LearningByMaking/Hardware/AppBoard1.3/partsReference.png

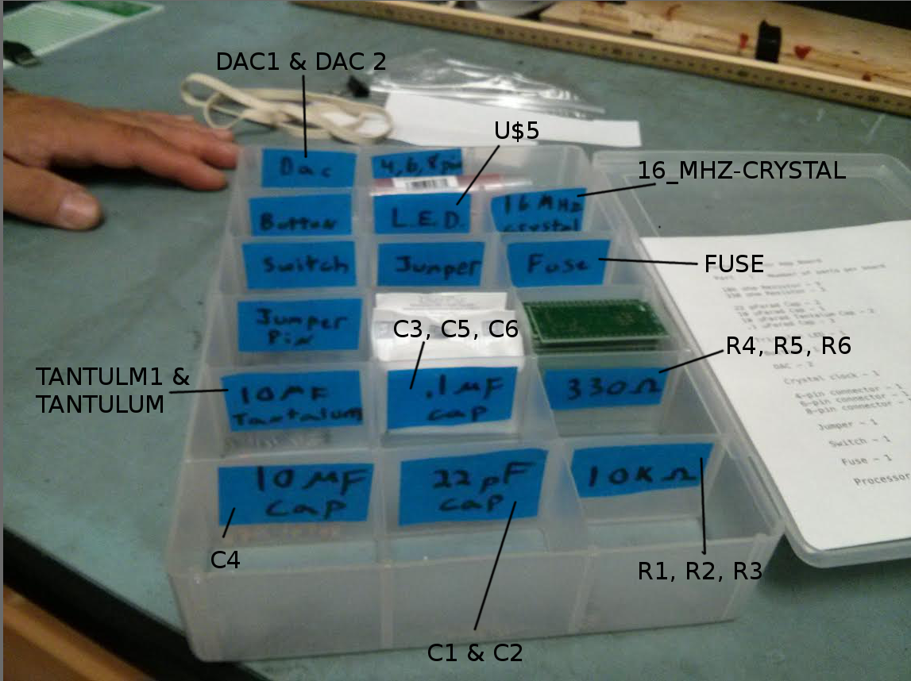
AppBoard1.3/partsReference.png
