LearningByMaking/Hardware/AppBoard1.3/Images/top_blank.jpg

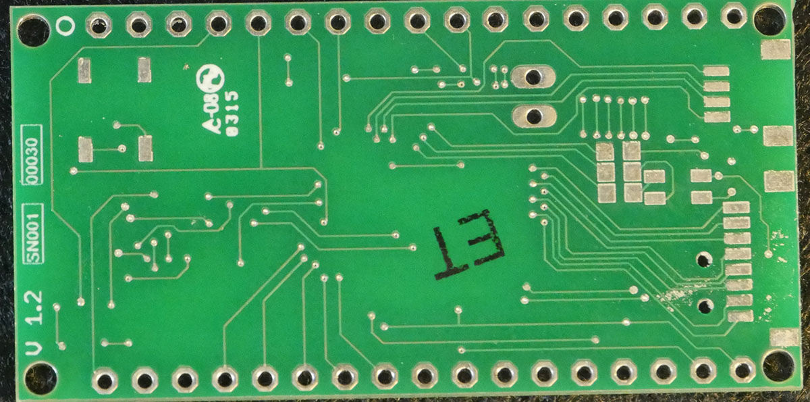
AppBoard1.3/Images/top_blank.jpg
