LearningByMaking/Hardware/README.md

# Hardware
The design files and documentation for the LbyM hardware
