LearningByMaking/Hardware/Protoboard/Docs/OuterHousing/CubeSat_mechanical-20160218-201846.pdf

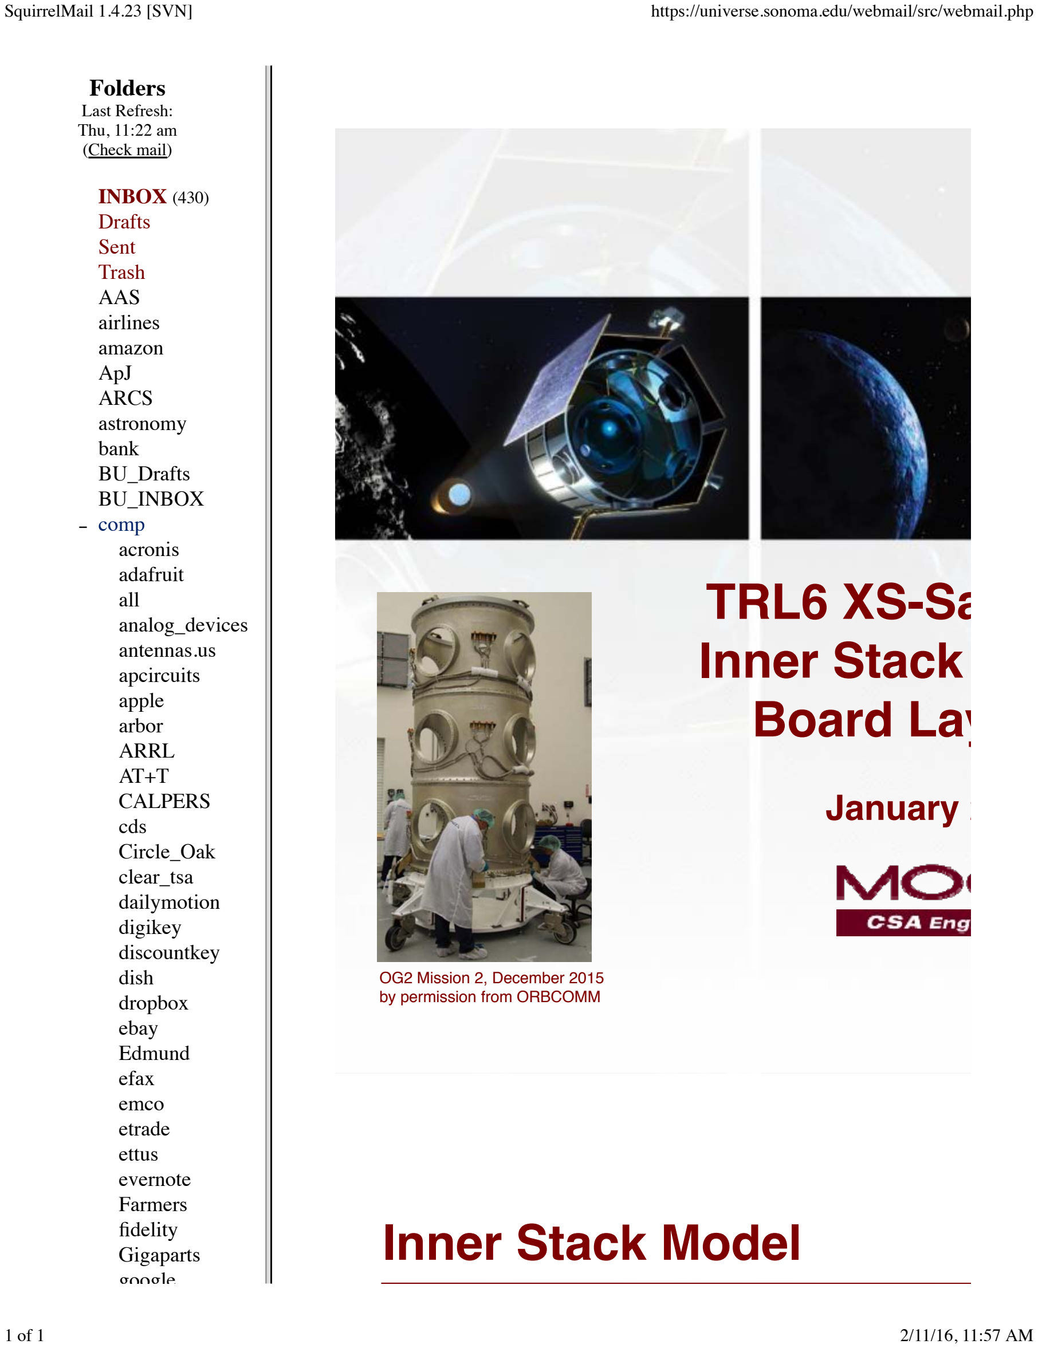
[picture p3: page 1]

Folders
Last Refresh:
Thu, 11:22 am
(Check mail)

INBOX (430)
Drafts
Sent
Trash
AAS
airlines
amazon
ApJ
ARCS
astronomy
bank
BU_Drafts
BU_INBOX
- comp
acronis
adafruit
all
analog_devices
antennas.us
apcircuits
apple
arbor
ARRL
AT+T
CALPERS
cds
Circle_Oak
clear_tsa
dailymotion
digikey
discountkey
dish
dropbox
ebay
Edmund
efax
emco
etrade
ettus
evernote
Farmers
fidelity
Gigaparts
google

# TRL6 XS-Sa Inner Stack Board Lay

## January 2

OG2 Mission 2, December 2015 by permission from ORBCOMM

# Inner Stack Model

SquirrelMail 1.4.23 [SVN] | https://universe.sonoma.edu/webmail/src/webmail.php
1 of 1 | 2/11/16, 11:57 AM
