LearningByMaking/Hardware/Protoboard/Docs/OuterHousing/XS-Sat Board Layout ICD 28Jan2016-20160212-193028.pdf

This technical Data/Drawing/Document contains information that is proprietary to, and is the express property of Moog Inc., or Moog Inc. subsidiaries except as expressly granted by contract or by operation of law and is restricted to use by only Moog employees and other persons authorized in writing by Moog or as expressly granted by contract or by operation of law. No portion of this Data/Drawing/Document shall be reproduced or disclosed or copied or furnished in whole or in part to others or used by others for any purpose whatsoever except as specifically authorized in writing by an authorized signatory of Moog Inc. or Moog Inc. subsidiaries.

# TRL6 XS-Sat CubeSat Inner Stack Model and Board Layout ICD

# January 28, 2016

## OG2 Mission 2, December 2015 by permission from ORBCOMM

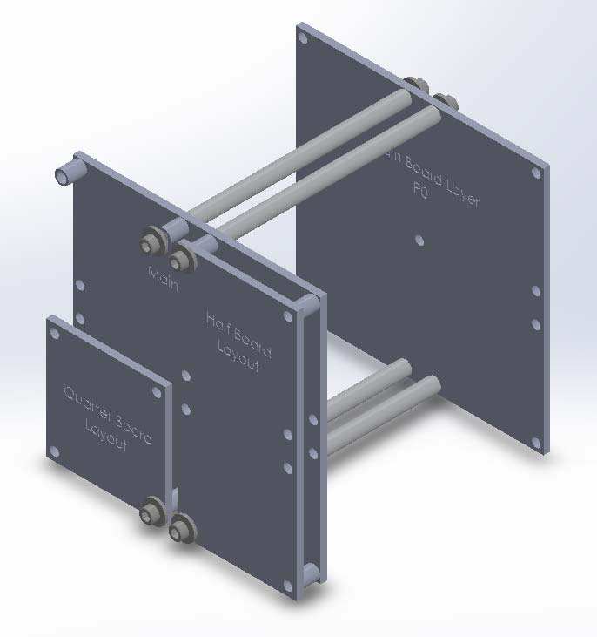
[picture p4: figure]

1 Moog Inc. Proprietary – see first slide for restrictions.

# Inner Stack Model

# Board Layouts and Templates Mechanical ICD

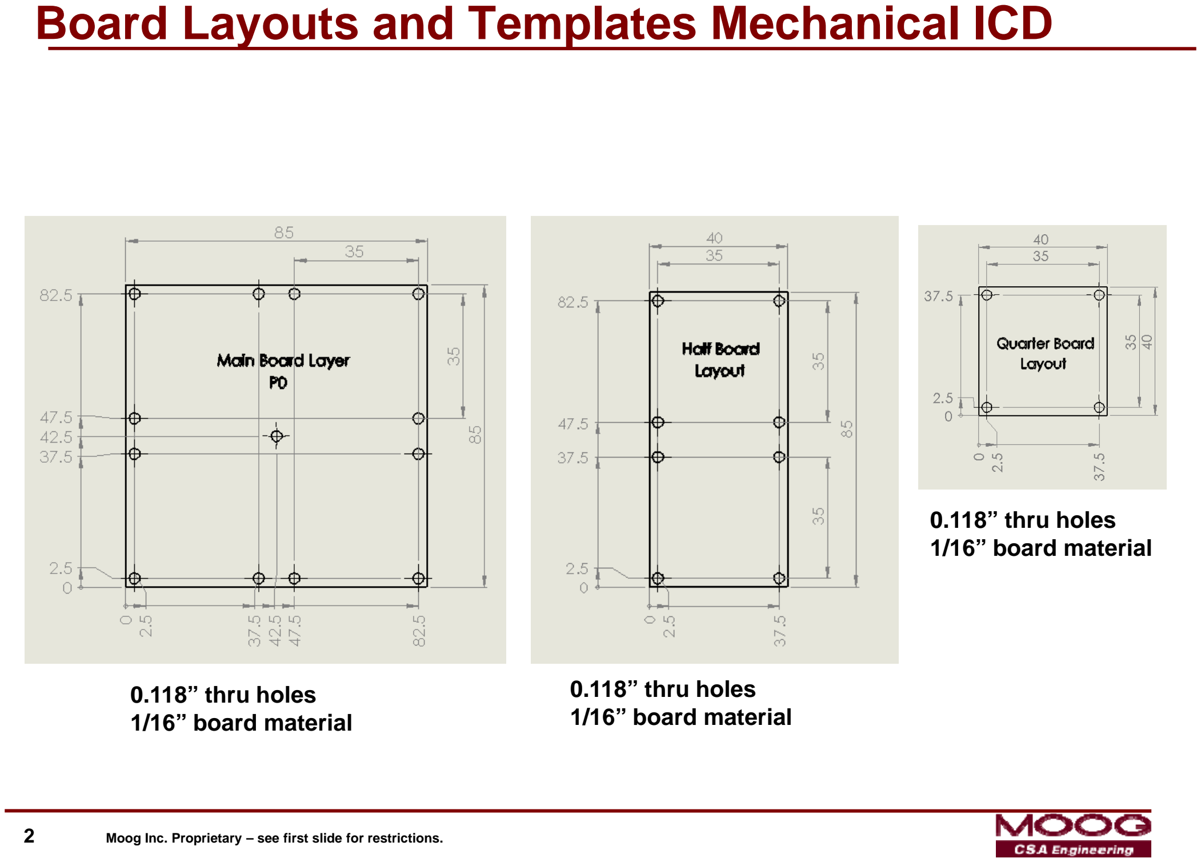
[picture p5: page 3]

2 Moog Inc. Proprietary – see first slide for restrictions.

# 0.118” thru holes 1/16” board material

# 0.118” thru holes 1/16” board material

# 0.118” thru holes 1/16” board material

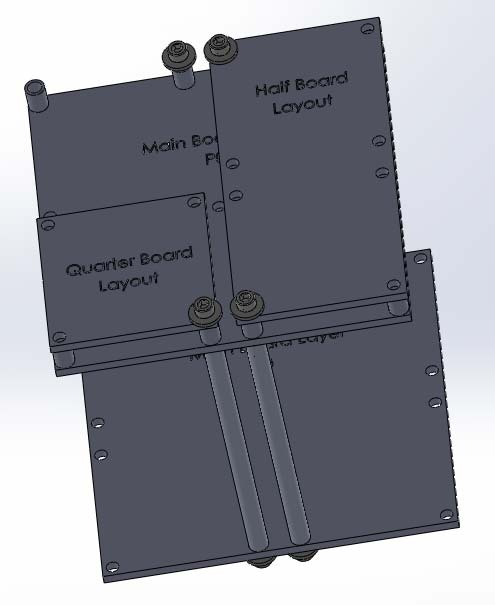
[picture p6: figure]

3 Moog Inc. Proprietary – see first slide for restrictions.

# Electrical ICD

# - Corner holes of Full Board are all ground - Middle holes need to be alternating Signal and Power

# – Layout of signal and power is still TBD
