LearningByMaking/Hardware/AppBoard1.3/Images/bottom.jpg

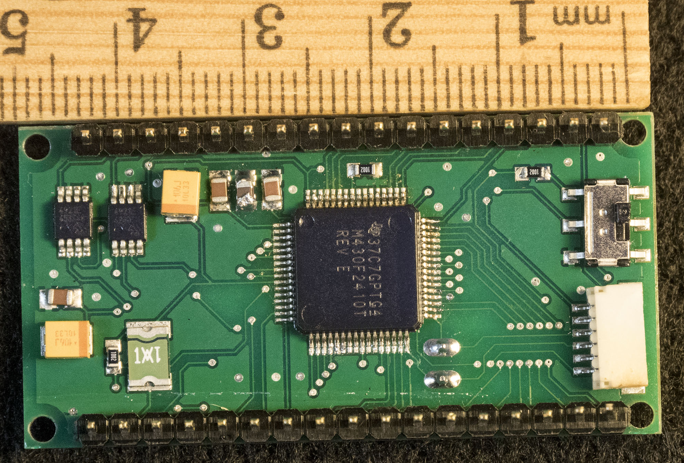
AppBoard1.3/Images/bottom.jpg
