LearningByMaking/Hardware/AppBoard1.3/Images/bottom_blank.jpg

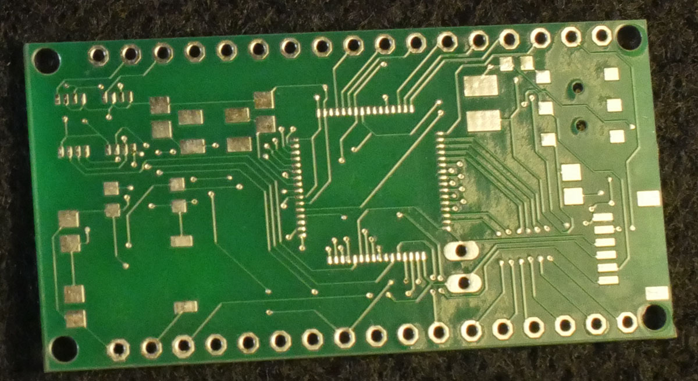
AppBoard1.3/Images/bottom_blank.jpg
