LearningByMaking/Hardware/AppBoard1.3/Images/bottom_with_header_pins.jpg

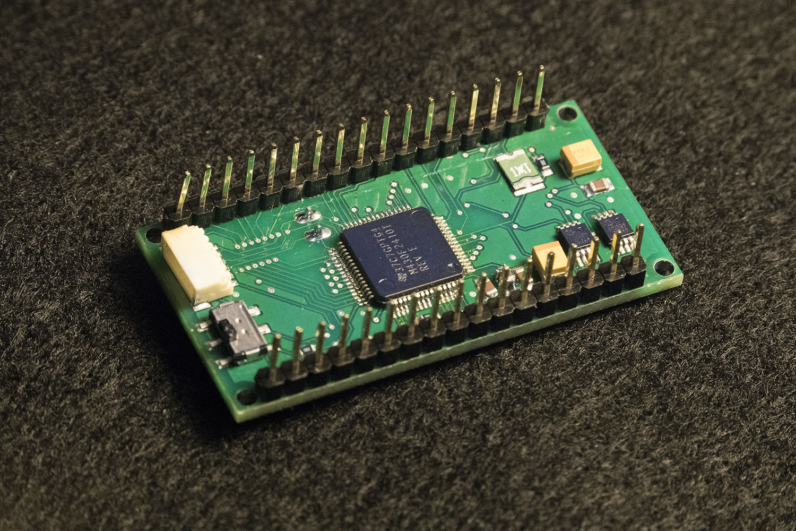
AppBoard1.3/Images/bottom_with_header_pins.jpg
