LearningByMaking/Hardware/AppBoard1.3/Images/top.jpg

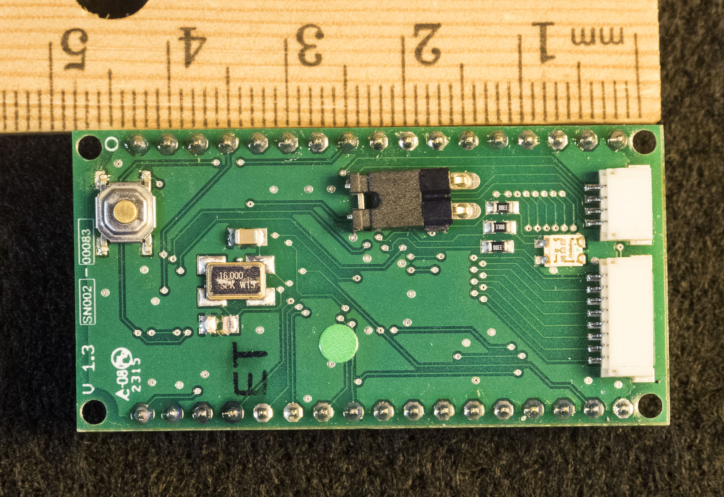
AppBoard1.3/Images/top.jpg
