LearningByMaking/Hardware/Protoboard/prototype-bottom_brd.png

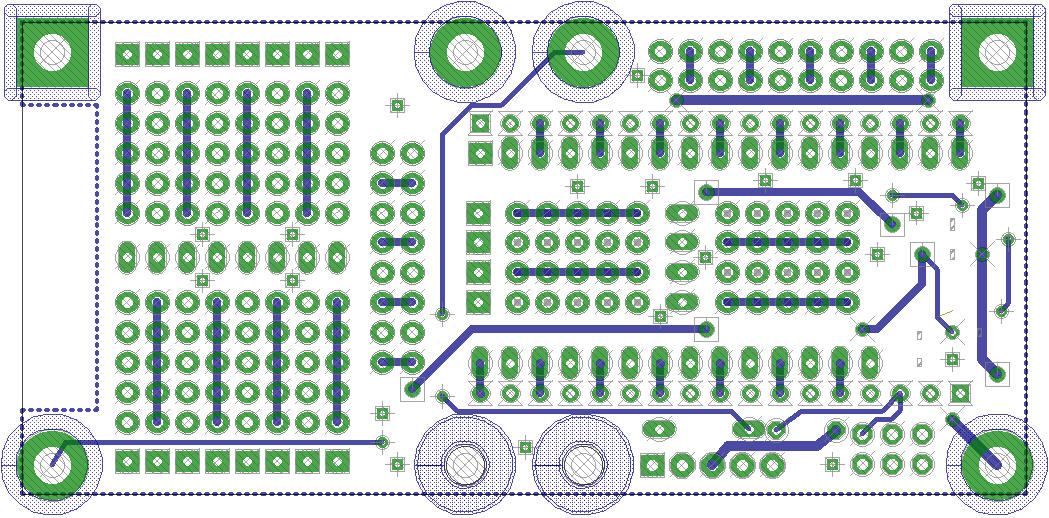
Protoboard/prototype-bottom_brd.png
