LearningByMaking/Hardware/Protoboard/prototype-bottom_w_gnd-plane_brd.png

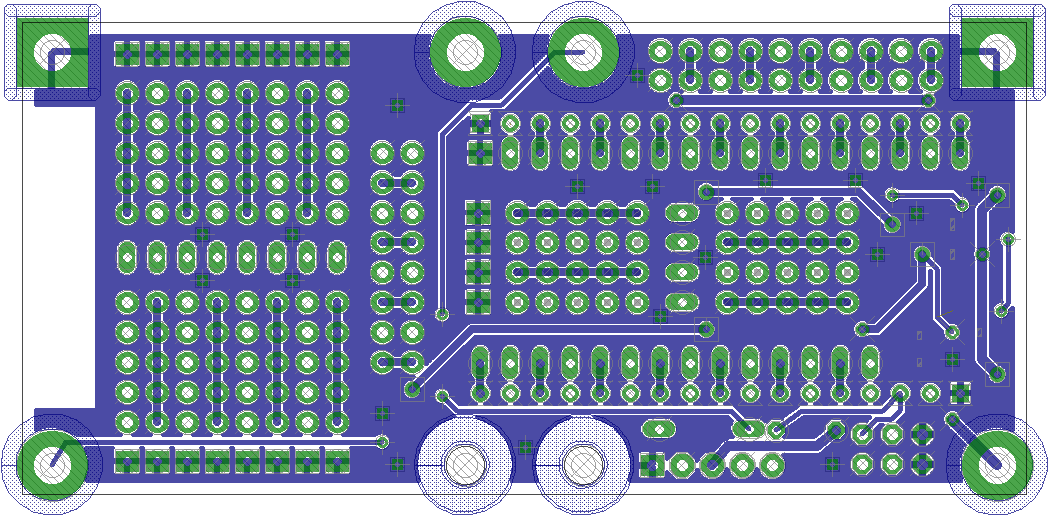
Protoboard/prototype-bottom_w_gnd-plane_brd.png
