LearningByMaking/Hardware/Protoboard/prototype-top-and-bottom_brd.png

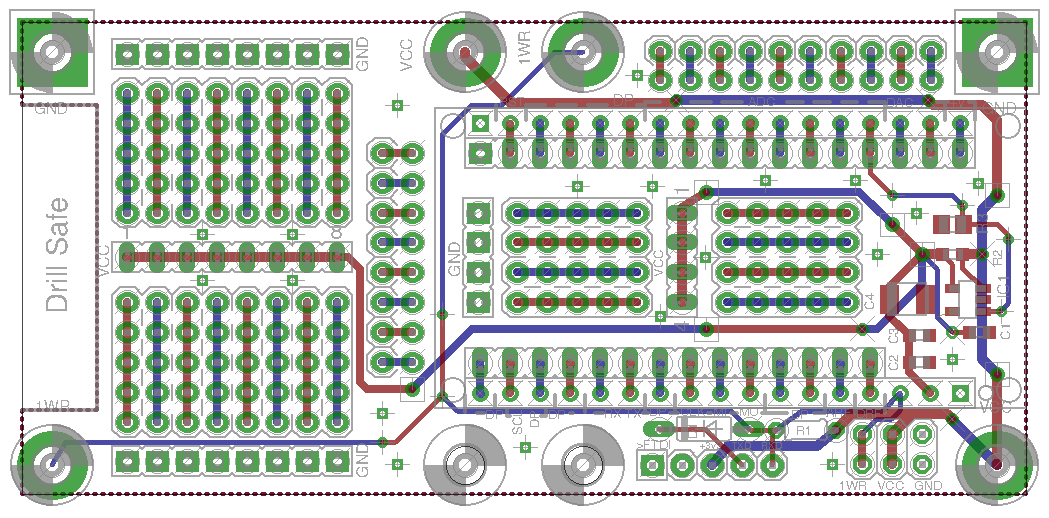
Protoboard/prototype-top-and-bottom_brd.png
