LearningByMaking/Hardware/Protoboard/prototype-top_brd.png

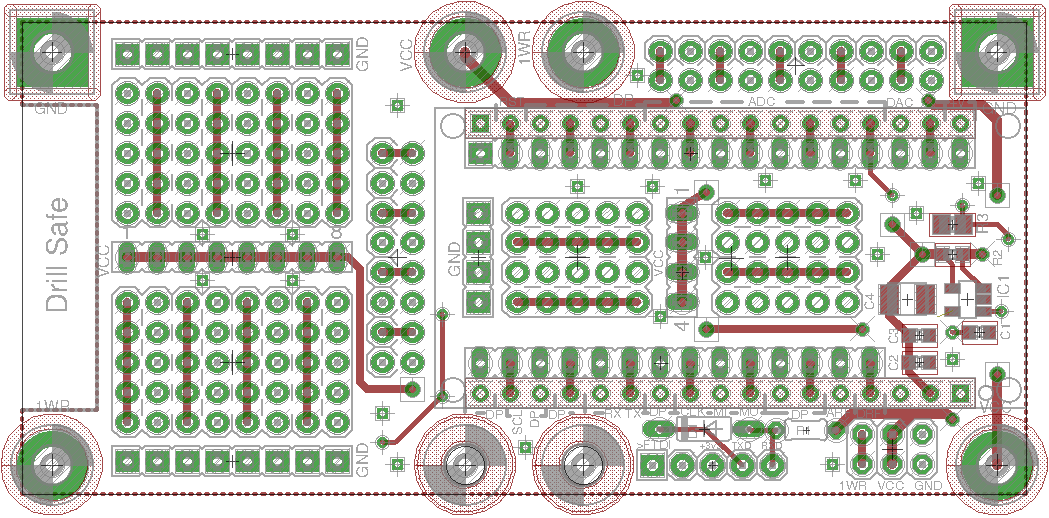
Protoboard/prototype-top_brd.png
