LearningByMaking/Hardware/Protoboard/prototype-top_w_gnd-plane_brd.png

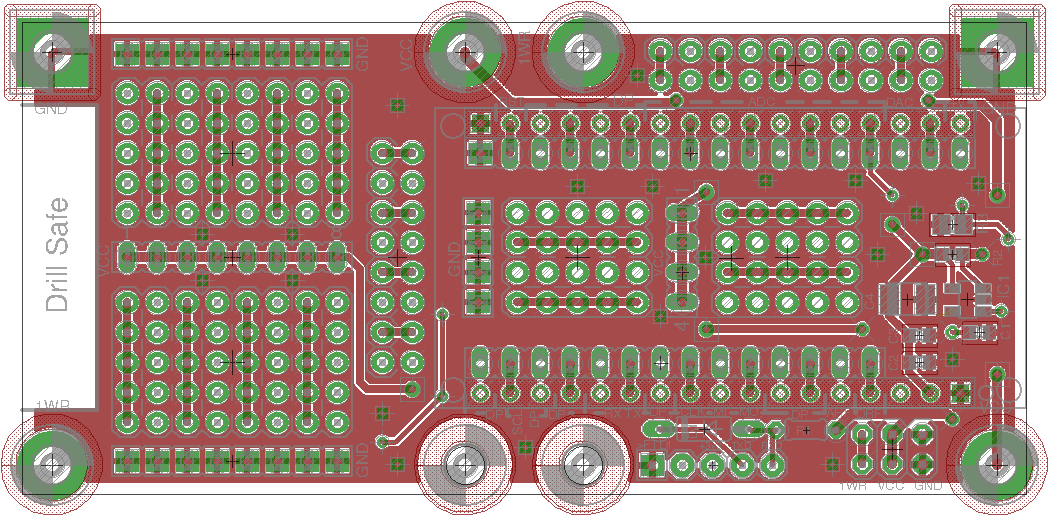
Protoboard/prototype-top_w_gnd-plane_brd.png
