LearningByMaking/Hardware/uStar/Layout.png

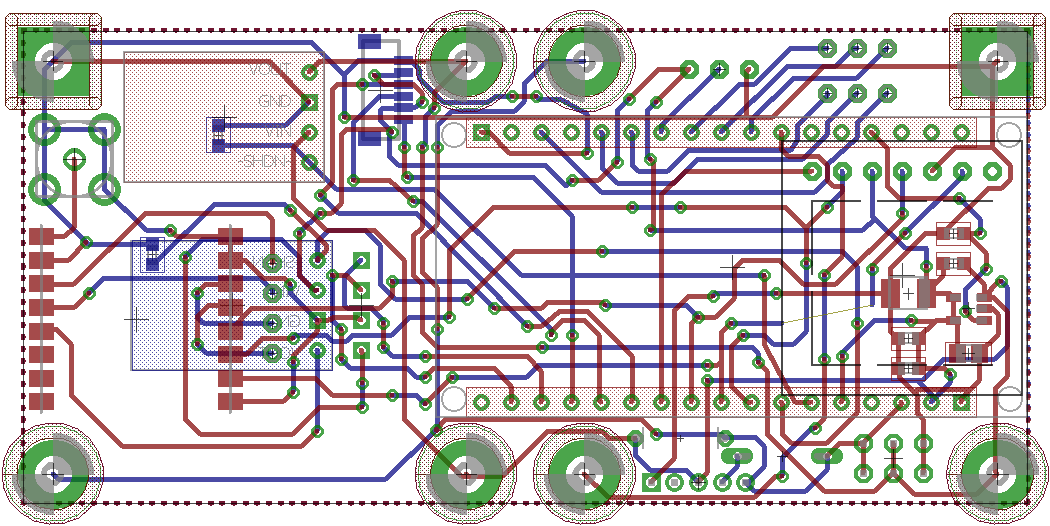
uStar/Layout.png
