LearningByMaking/Hardware/uStar/PlacementGuid.png

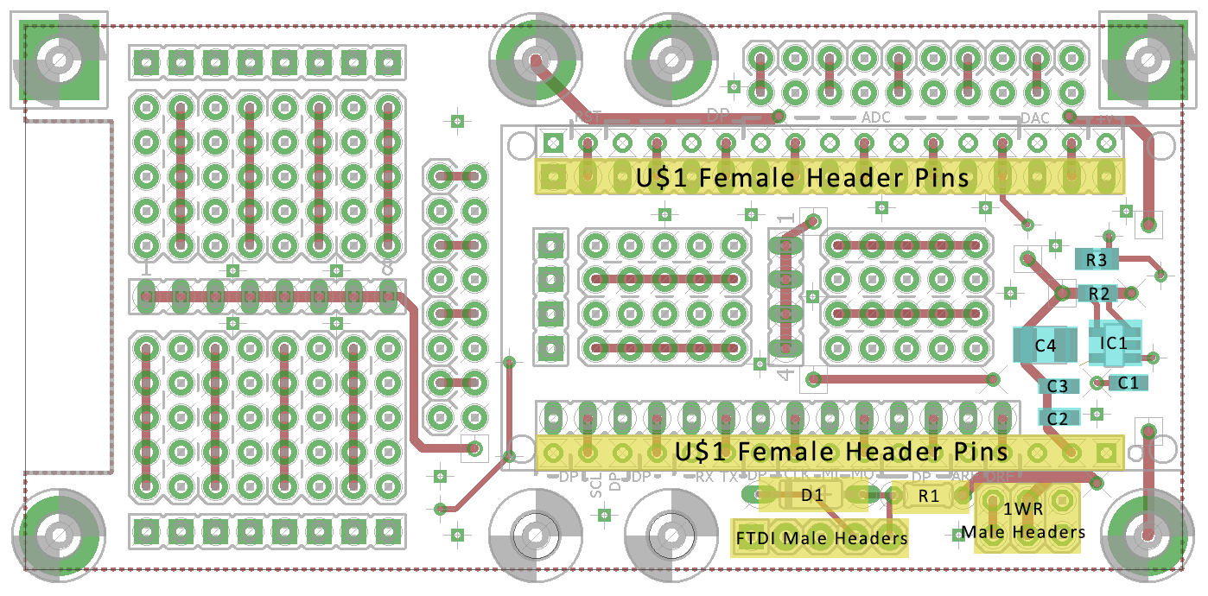
uStar/PlacementGuid.png
