LearningByMaking/Hardware/uStar/Schematic.png

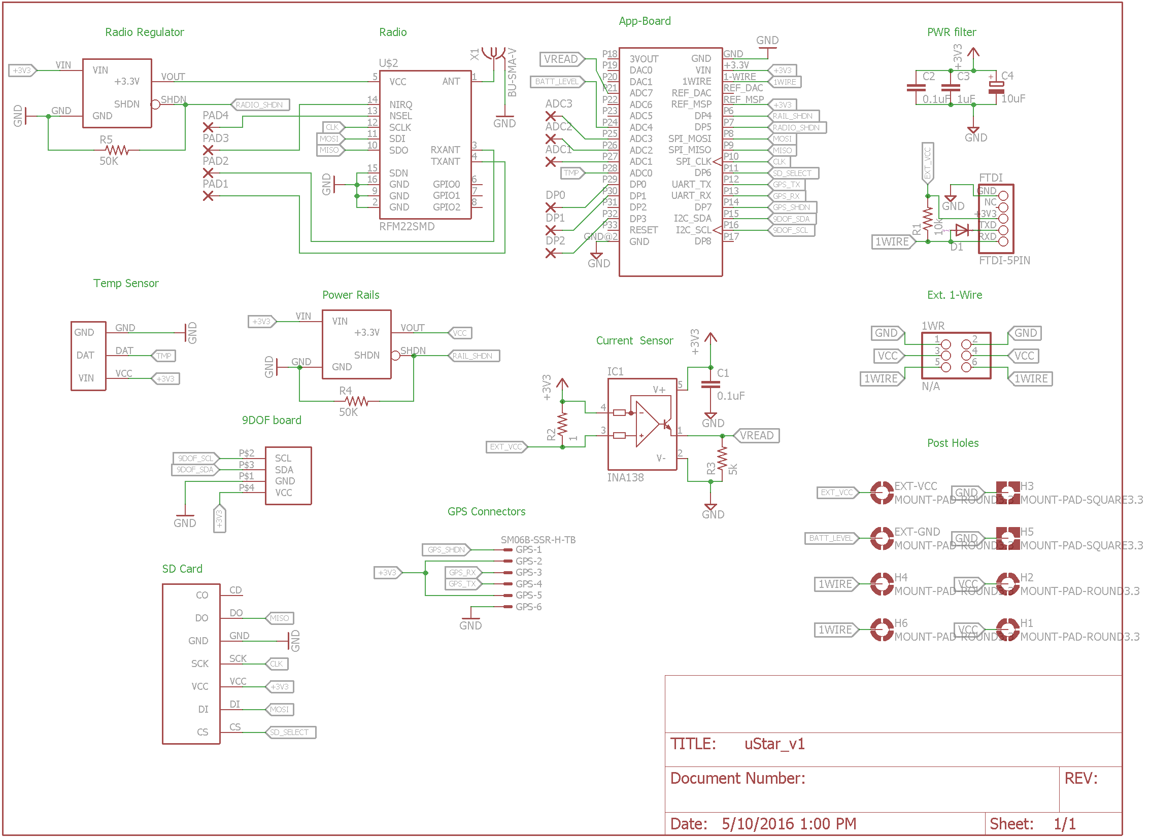
uStar/Schematic.png
