LearningByMaking/Hardware/uStar/uStarBottom.png

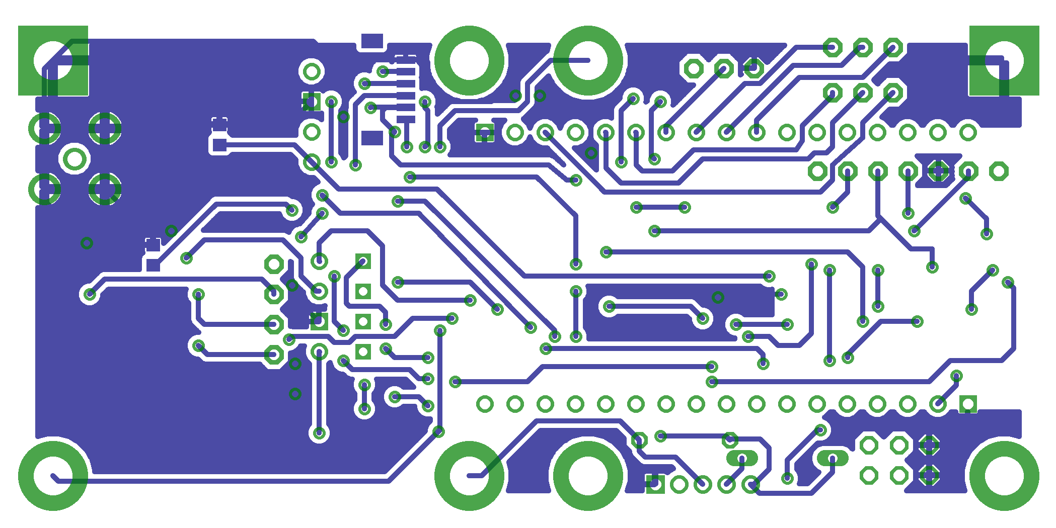
uStar/uStarBottom.png
