LearningByMaking/Hardware/uStar/uStarTop.png

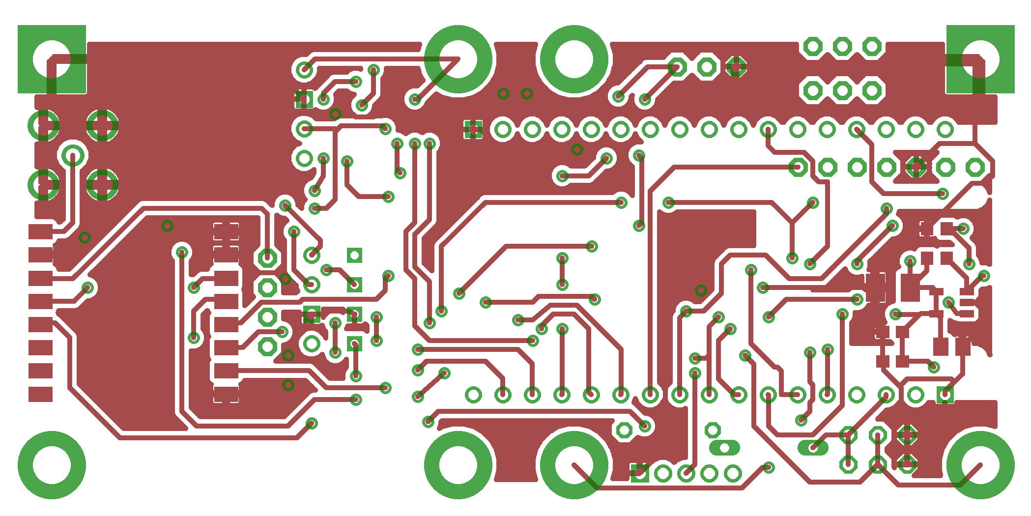
uStar/uStarTop.png
