LearningByMaking/Hardware/Protoboard/ProtoboardPartList.xlsx

Part | Value | Device | Package | Library | Link | Cost
C1 | 0.1uF | C-EUC0603 | C0603 | resistor | http://www.mouser.com/Search/ProductDetail.aspx | 0.1
C2 | 0.1uF | C-EUC0603 | C0603 | resistor | http://www.mouser.com/Search/ProductDetail.aspx | 0.1
C3 | 1uF | C-EUC0603 | C0603 | resistor | http://www.mouser.com/Search/ProductDetail.aspx | 0.29
C4 | 10uF | CPOL-EUSMCB | SMC_B | resistor | http://www.mouser.com/Search/ProductDetail.aspx | 0.28
D1 | 1N4148DO35-7 | 1N4148DO35-7 | DO35-7 | diode | https://www.amazon.com/dp/B0149K5WH2 | 0.15
FTDI | FTDI-5PIN | FTDI-5PIN | 1X05 | FTDI | https://www.sparkfun.com/products/116 | 0.1875
IC1 | INA138 | INA138 | SOT23-5 | burr-brown | http://www.mouser.com/Search/ProductDetail.aspx | 1.72
R1 | 10k | R-US_0204/5 | 0204/5 | resistor | https://www.sparkfun.com/products/11508 | 0.25
R2 | 1 | R-US_R0603 | R0603 | resistor | http://www.mouser.com/Search/ProductDetail.aspx | 0.29
R3 | 5k | R-US_R0805 | R0805 | resistor | http://www.mouser.com/Search/ProductDetail.aspx | 1.79
U$1 | Left Side | App-Board 1.2/1.3 | pin | LbyM | http://www.mouser.com/Search/ProductDetail.aspx | 2.58
U$1 | Right Side | App-Board 1.2/1.3 | pin | LbyM | http://www.mouser.com/Search/ProductDetail.aspx | 2.58
NA | Jumper Pins | Jumper Pins | Pin | LbyM | http://www.mouser.com/Search/ProductDetail.aspx | 0.42
 |  |  |  |  | Total | 10.7375
