LearningByMaking/Hardware/AppBoard1.2/AppBoardParts.xlsx

Sheet: Sheet1
Part | Value | Device | Package | Library | Cost | Link
X2 | SM04B-SRSS-TB | 4 Pin parallel connector | SM04B-SRSS-TB | con-jst2 | $0.79 | http://www.digikey.com/product-detail/en/SM04B-SRSS-TB(LF)(SN)/455-1804-1-ND/926875
X1 | SM08B-SRSS-TB | 8 Pin parallel connector | SM08B-SRSS-TB | con-jst2 | $0.79 | http://www.digikey.com/product-detail/en/SM08B-SRSS-TB(LF)(SN)/455-1808-2-ND/926714
X3 | SM06B-SRSS-TB | 6 pin parallel connector | SM06B-SRSS-TB | con-jst2 | $0.79 | http://www.digikey.com/product-detail/en/SM06B-SRSS-TB(LF)(SN)/455-1806-1-ND/926877
VM_SWITC | H1 DPDT | SWITCH-DPDTAYZ0202 | AYZ0202 | SparkFun-Electromechanical | $1.22 | http://www.mouser.com/ProductDetail/CK-Components/AYZ0202AGRLC/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
JP1 |  | JP1E | JP1 | jumper | $0.10 | http://www.mouser.com/ProductDetail/3M-Electronic-Solutions-Division/969102-0000-DA/
U$1 | MSP430 | MSP430 | MSP430 | LearningByMaking | $10.35 | http://www.mouser.com/ProductDetail/Texas-Instruments/MSP430F2410TPMR/
U$3 | MINISMDC110F-2 | MINISMDC110F-2 | MINISMDC110 | LearningByMaking | $0.46 | http://www.mouser.com/ProductDetail/TE-Connectivity-Raychem/MINISMDC110F-24-2/
DAC1 | MCP4921_SMD | MCP4921_SMD | MCP4921_SMD | PocketCube | $2.08 | http://www.mouser.com/ProductDetail/Microchip-Technology/MCP4921-E-MS/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
DAC2 | MCP4921_SMD | MCP4921_SMD | MCP4921_SMD | PocketCube | $2.08 | http://www.mouser.com/ProductDetail/Microchip-Technology/MCP4921-E-MS/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
C1 | 10uF | C-USC0805 | C0805 | rcl | $0.21 | http://www.mouser.com/ProductDetail/Kemet/C0805C106K8PACTU/?qs=sGAEpiMZZMs0AnBnWHyRQI9zuYIiQALCxT7NLyqb6iU%3d
C2 | 0.1uF | C-USC0805 | C0805 | rcl | $0.10 | http://www.mouser.com/ProductDetail/Kemet/C0805C104K5RACTU/
C3 | 22pF | C-USC0805 | C0805 | rcl | $0.06 | http://www.mouser.com/ProductDetail/Vishay-Vitramon/VJ0805A220GXACW1BC/?qs=eSjamwHkOJ3pP2pmSgCw%252bA==
C4 | 22pF | C-USC0805 | C0805 | rcl | $0.06 | http://www.mouser.com/ProductDetail/Vishay-Vitramon/VJ0805A220GXACW1BC/?qs=eSjamwHkOJ3pP2pmSgCw%252bA==
C5 | 0.1uF | C-USC0805 | C0805 | rcl | $0.10 | http://www.mouser.com/ProductDetail/Kemet/C0805C104K5RACTU/
C6 | 10uF | C-USC1210 | C1210 | rcl | $0.73 | http://www.mouser.com/ProductDetail/AVX/TAJB106K016RNJ/
R1 | 10k | R-US_R0603 | R0603 | rcl | $0.12 | http://www.mouser.com/ProductDetail/Welwyn-Components-TT-Electronics/WCR0603-10KFA/
R2 | 10k | R-US_R0603 | R0603 | rcl | $0.12 | http://www.mouser.com/ProductDetail/Welwyn-Components-TT-Electronics/WCR0603-10KFA/
R3 | 10k | R-US_R0603 | R0603 | rcl | $0.12 | http://www.mouser.com/ProductDetail/Welwyn-Components-TT-Electronics/WCR0603-10KFA/
R4 | 100 | R-US_R0603 | R0603 | rcl | $0.08 | http://www.mouser.com/ProductDetail/Vishay-Dale/CRCW0603100RFKEA/
R5 | 100 | R-US_R0603 | R0603 | rcl | $0.08 | http://www.mouser.com/ProductDetail/Vishay-Dale/CRCW0603100RFKEA/
R12 | 100 | R-US_R0603 | R0603 | rcl | $0.08 | http://www.mouser.com/ProductDetail/Vishay-Dale/CRCW0603100RFKEA/
RESET1 | SWITCH-MOMENTARY-2SMD | SWITCH-MOMENTARY-2SMD | TACTILE_SWITCH_SMD | SparkFun-Electromechanical | $0.95 | https://www.sparkfun.com/products/8229
16MHZ |  | CRYSTAL5X3 | CRYSTAL-SMD-5X3 | SparkFun-FreqCtrl | $1.50 | https://www.sparkfun.com/products/94
LED1 | LED-TRICOLOR | LED-TRICOLOR | LED-TRICOLOR-SMD | SparkFun-LED | $2.25 | https://www.sparkfun.com/products/7844
3V3OUT |  | 1,6/0,8 | 1,6/0,8 | wirepad
DP1 |  | 1,6/0,8 | 1,6/0,8 | wirepad
DP2 |  | 1,6/0,8 | 1,6/0,8 | wirepad
P6 |  | 1,6/0,8 | 1,6/0,8 | wirepad
P14 |  | 1,6/0,8 | 1,6/0,8 | wirepad
P15 |  | 1,6/0,8 | 1,6/0,8 | wirepad
P16 |  | 1,6/0,8 | 1,6/0,8 | wirepad
P17 |  | 1,6/0,8 | 1,6/0,8 | wirepad
P18 |  | 1,6/0,8 | 1,6/0,8 | wirepad
P19 |  | SMD2 | SMD1,27-2,54 | wirepad
P26 |  | SMD2 | SMD1,27-2,54 | wirepad
P29 |  | 1,6/0,8 | 1,6/0,8 | wirepad
P30 |  | 1,6/0,8 | 1,6/0,8 | wirepad
P32 |  | 1,6/0,8 | 1,6/0,8 | wirepad
P34 |  | SMD2 | SMD1,27-2,54 | wirepad
P35 |  | SMD2 | SMD1,27-2,54 | wirepad
P36 |  | 1,6/0,8 | 1,6/0,8 | wirepad
P37 |  | 1,6/0,8 | 1,6/0,8 | wirepad
P38 |  | 1,6/0,8 | 1,6/0,8 | wirepad
P39 |  | 1,6/0,8 | 1,6/0,8 | wirepad
P40 |  | 1,6/0,8 | 1,6/0,8 | wirepad
P41 |  | 1,6/0,8 | 1,6/0,8 | wirepad
P42 |  | 1,6/0,8 | 1,6/0,8 | wirepad
P43 |  | 1,6/0,8 | 1,6/0,8 | wirepad
P44 |  | SMD2 | SMD1,27-2,54 | wirepad
P45 |  | 1,6/0,8 | 1,6/0,8 | wirepad
P46 |  | 1,6/0,8 | 1,6/0,8 | wirepad
P47 |  | 1,6/0,8 | 1,6/0,8 | wirepad
P48 |  | 1,6/0,8 | 1,6/0,8 | wirepad
P49 |  | 1,6/0,8 | 1,6/0,8 | wirepad
P50 |  | 1,6/0,8 | 1,6/0,8 | wirepad
P51 |  | 1,6/0,8 | 1,6/0,8 | wirepad
P52 |  | 1,6/0,8 | 1,6/0,8 | wirepad
P53 |  | 1,6/0,8 | 1,6/0,8 | wirepad
P54 |  | 1,6/0,8 | 1,6/0,8 | wirepad
P55 |  | 1,6/0,8 | 1,6/0,8 | wirepad
P56 |  | SMD2 | SMD1,27-2,54 | wirepad
P59 |  | 1,6/0,8 | 1,6/0,8 | wirepad
P60 |  | 1,6/0,8 | 1,6/0,8 | wirepad
P61 |  | 1,6/0,8 | 1,6/0,8 | wirepad
PGND |  | 1,6/0,8 | 1,6/0,8 | wirepad
VIN |  | 1,6/0,8 | 1,6/0,8 | wirepad

Sheet: Sheet2
X2 | SM04B-SRSS-TB | 4 Pin parallel connector | SM04B-SRSS-TB | con-jst2 | 1 | 50 | $0.79 | $0.79 | http://www.digikey.com/product-detail/en/SM04B-SRSS-TB(LF)(SN)/455-1804-1-ND/926875
X3 | SM06B-SRSS-TB | 6 pin parallel connector | SM06B-SRSS-TB | con-jst2 | 1 | 50 | $0.79 | $0.79 | http://www.digikey.com/product-detail/en/SM06B-SRSS-TB(LF)(SN)/455-1806-1-ND/926877
X1 | SM08B-SRSS-TB | 8 Pin parallel connector | SM08B-SRSS-TB | con-jst2 | 1 | 50 | $0.79 | $0.79 | http://www.digikey.com/product-detail/en/SM08B-SRSS-TB(LF)(SN)/455-1808-2-ND/926714
JP1 |  | JP1E | JP1 | jumper | 1 | 50 | $0.10 | $0.10 | http://www.mouser.com/ProductDetail/3M-Electronic-Solutions-Division/969102-0000-DA/
C6 | 10uF | C-USC1210 | C1210 | rcl | 1 | 50 | $0.73 | $0.73 | http://www.mouser.com/ProductDetail/AVX/TAJB106K016RNJ/
VM_SWITC | H1 DPDT | SWITCH-DPDTAYZ0202 | AYZ0202 | SparkFun-Electromechanical | 1 | 50 | $1.22 | $1.22 | http://www.mouser.com/ProductDetail/CK-Components/AYZ0202AGRLC/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
C2 | 0.1uF | C-USC0805 | C0805 | rcl | 1 | 50 | $0.10 | $0.10 | http://www.mouser.com/ProductDetail/Kemet/C0805C104K5RACTU/
C5 | 0.1uF | C-USC0805 | C0805 | rcl | 1 | 50 | $0.10 | $0.10 | http://www.mouser.com/ProductDetail/Kemet/C0805C104K5RACTU/
C1 | 10uF | C-USC0805 | C0805 | rcl | 1 | 50 | $0.21 | $0.21 | http://www.mouser.com/ProductDetail/Kemet/C0805C106K8PACTU/?qs=sGAEpiMZZMs0AnBnWHyRQI9zuYIiQALCxT7NLyqb6iU%3d
DAC1, DAC2 | MCP4921_SMD | MCP4921_SMD | MCP4921_SMD | PocketCube | 2 | 100 | $2.08 | $4.16 | http://www.mouser.com/ProductDetail/Microchip-Technology/MCP4921-E-MS/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
U$3 | MINISMDC110F-2 | MINISMDC110F-2 | MINISMDC110 | LearningByMaking | 1 | 50 | $0.46 | $0.46 | http://www.mouser.com/ProductDetail/TE-Connectivity-Raychem/MINISMDC110F-24-2/
U$1 | MSP430 | MSP430 | MSP430 | LearningByMaking | 1 | 50 | $10.35 | $10.35 | http://www.mouser.com/ProductDetail/Texas-Instruments/MSP430F2410TPMR/
R4, R5, R12 | 100 | R-US_R0603 | R0603 | rcl | 3 | 150 | $0.08 | $0.24 | http://www.mouser.com/ProductDetail/Vishay-Dale/CRCW0603100RFKEA/
C3 | 22pF | C-USC0805 | C0805 | rcl | 1 | 50 | $0.06 | $0.06 | http://www.mouser.com/ProductDetail/Vishay-Vitramon/VJ0805A220GXACW1BC/?qs=eSjamwHkOJ3pP2pmSgCw%252bA==
C4 | 22pF | C-USC0805 | C0805 | rcl | 1 | 50 | $0.06 | $0.06 | http://www.mouser.com/ProductDetail/Vishay-Vitramon/VJ0805A220GXACW1BC/?qs=eSjamwHkOJ3pP2pmSgCw%252bA==
R1,R2,R3 | 10k | R-US_R0603 | R0603 | rcl | 3 | 150 | $0.12 | $0.36 | http://www.mouser.com/ProductDetail/Welwyn-Components-TT-Electronics/WCR0603-10KFA/
LED1 | LED-TRICOLOR | LED-TRICOLOR | LED-TRICOLOR-SMD | SparkFun-LED | 1 | 50 | $2.25 | $2.25 | https://www.sparkfun.com/products/7844
RESET1 | SWITCH-MOMENTARY-2SMD | SWITCH-MOMENTARY-2SMD | TACTILE_SWITCH_SMD | SparkFun-Electromechanical | 1 | 50 | $0.95 | $0.95 | https://www.sparkfun.com/products/8229
16MHZ |  | CRYSTAL5X3 | CRYSTAL-SMD-5X3 | SparkFun-FreqCtrl | 1 | 50 | $1.50 | $1.50 | https://www.sparkfun.com/products/94
N/A | Header Pins | Breakaway Header Pins |  |  | 1 | 50 | $2.95 | $2.95 | https://www.sparkfun.com/products/117
