LearningByMaking/Hardware/Protoboard/Docs/Solder-able_Breadboard/Solder-able_Breadboard-master/README.md

Solder-able Breadboard
=======================

[Solder-able Breadboard 
*Solder-able Breadboard(PRT-12070)*](https://www.sparkfun.com/products/12070)

This is a bare pcb that is the same size as a regular breadboard, along with the same connections and power rails.

Repository Contents
-------------------
* **/Hardware** - All Eagle design files (.brd, .sch)

License Information
-------------------
The hardware is released under [Creative Commons Share-alike 3.0](http://creativecommons.org/licenses/by-sa/3.0/).
