LearningByMaking/Hardware/Protoboard/Protoboard_PlacementGuide.png

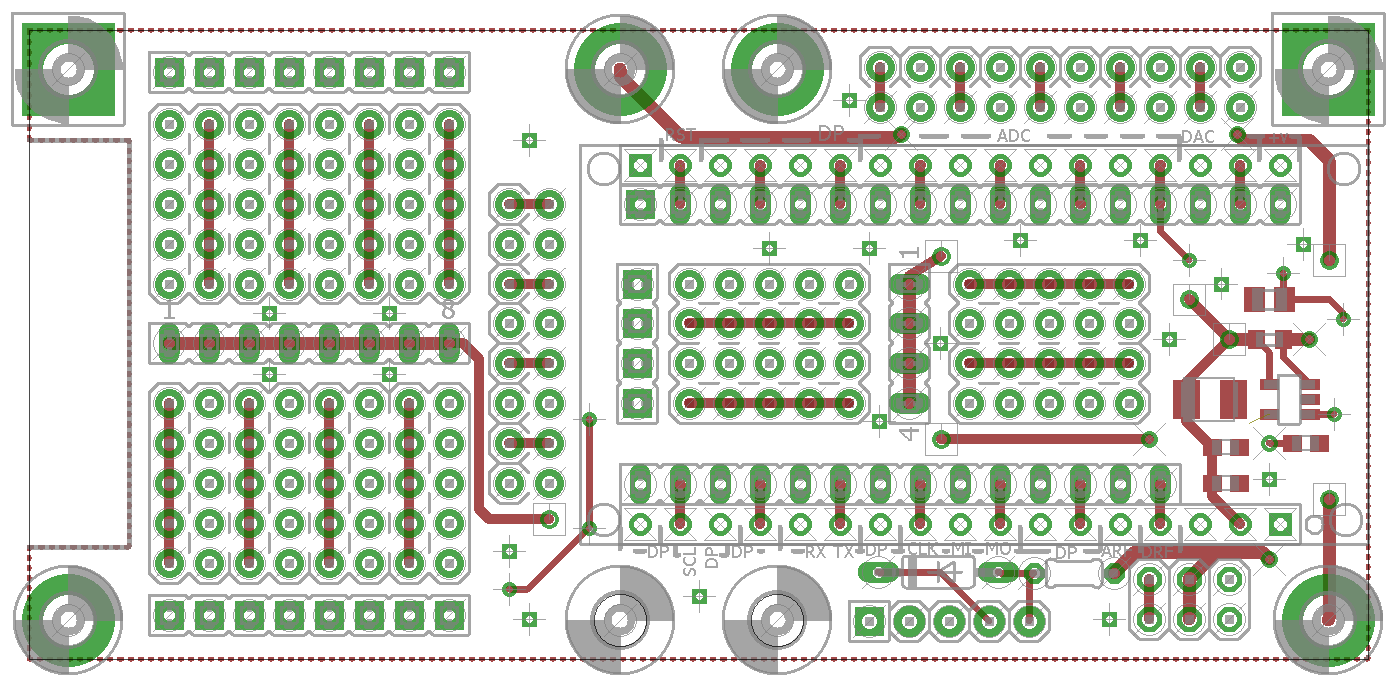
Protoboard/Protoboard_PlacementGuide.png
