LearningByMaking/Hardware/Protoboard/Docs/Solder-able_Breadboard/Solder-able_Breadboard-master/protoboard_measured.png

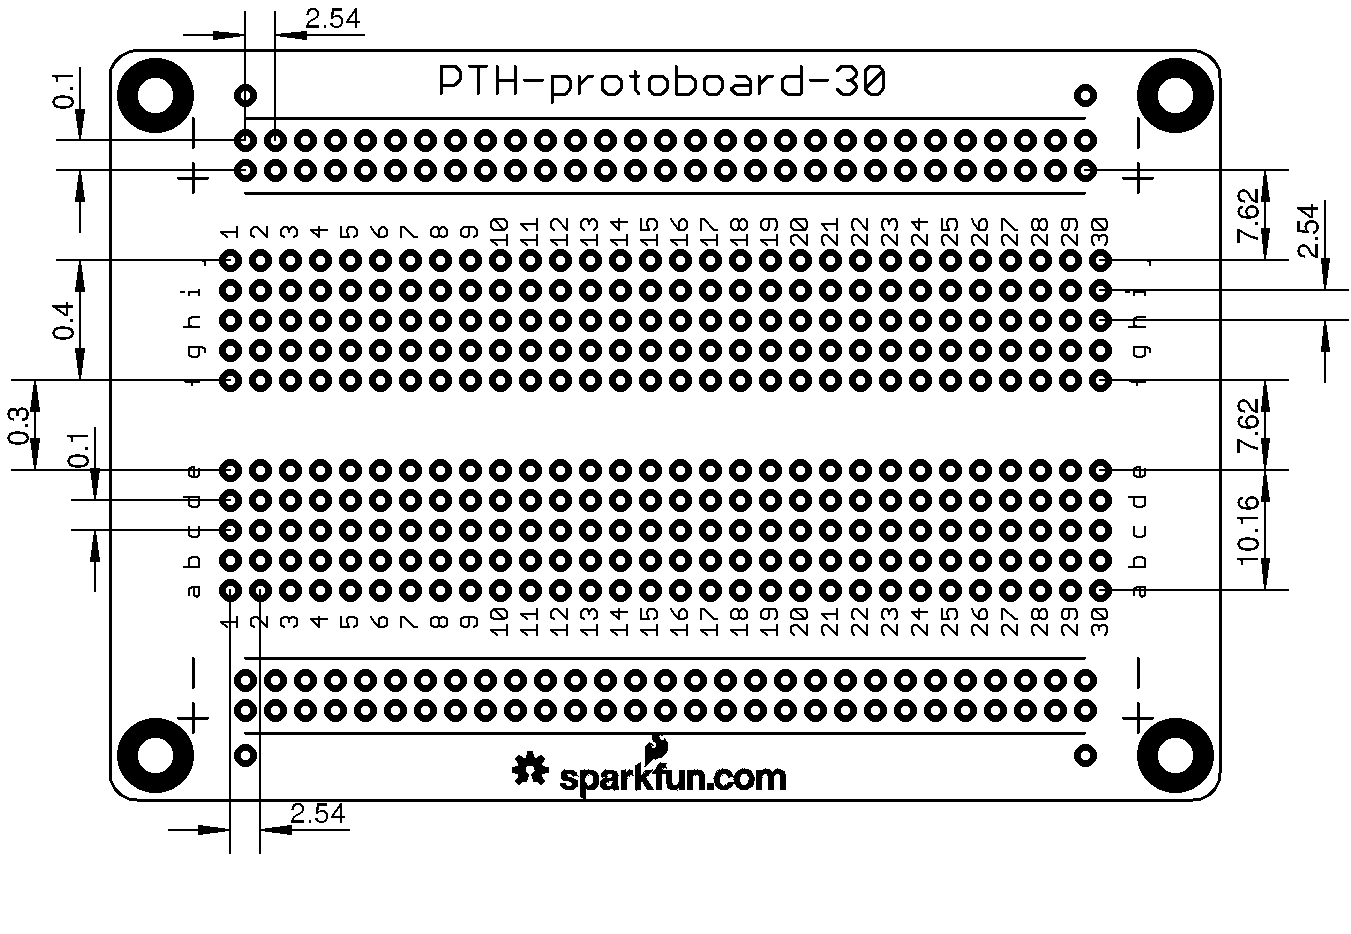
Protoboard/Docs/Solder-able_Breadboard/Solder-able_Breadboard-master/protoboard_measured.png
