LearningByMaking/Hardware/Protoboard/Docs/Solder-able_Breadboard/Solder-able_Breadboard-master/SIK-DIP-board.pdf

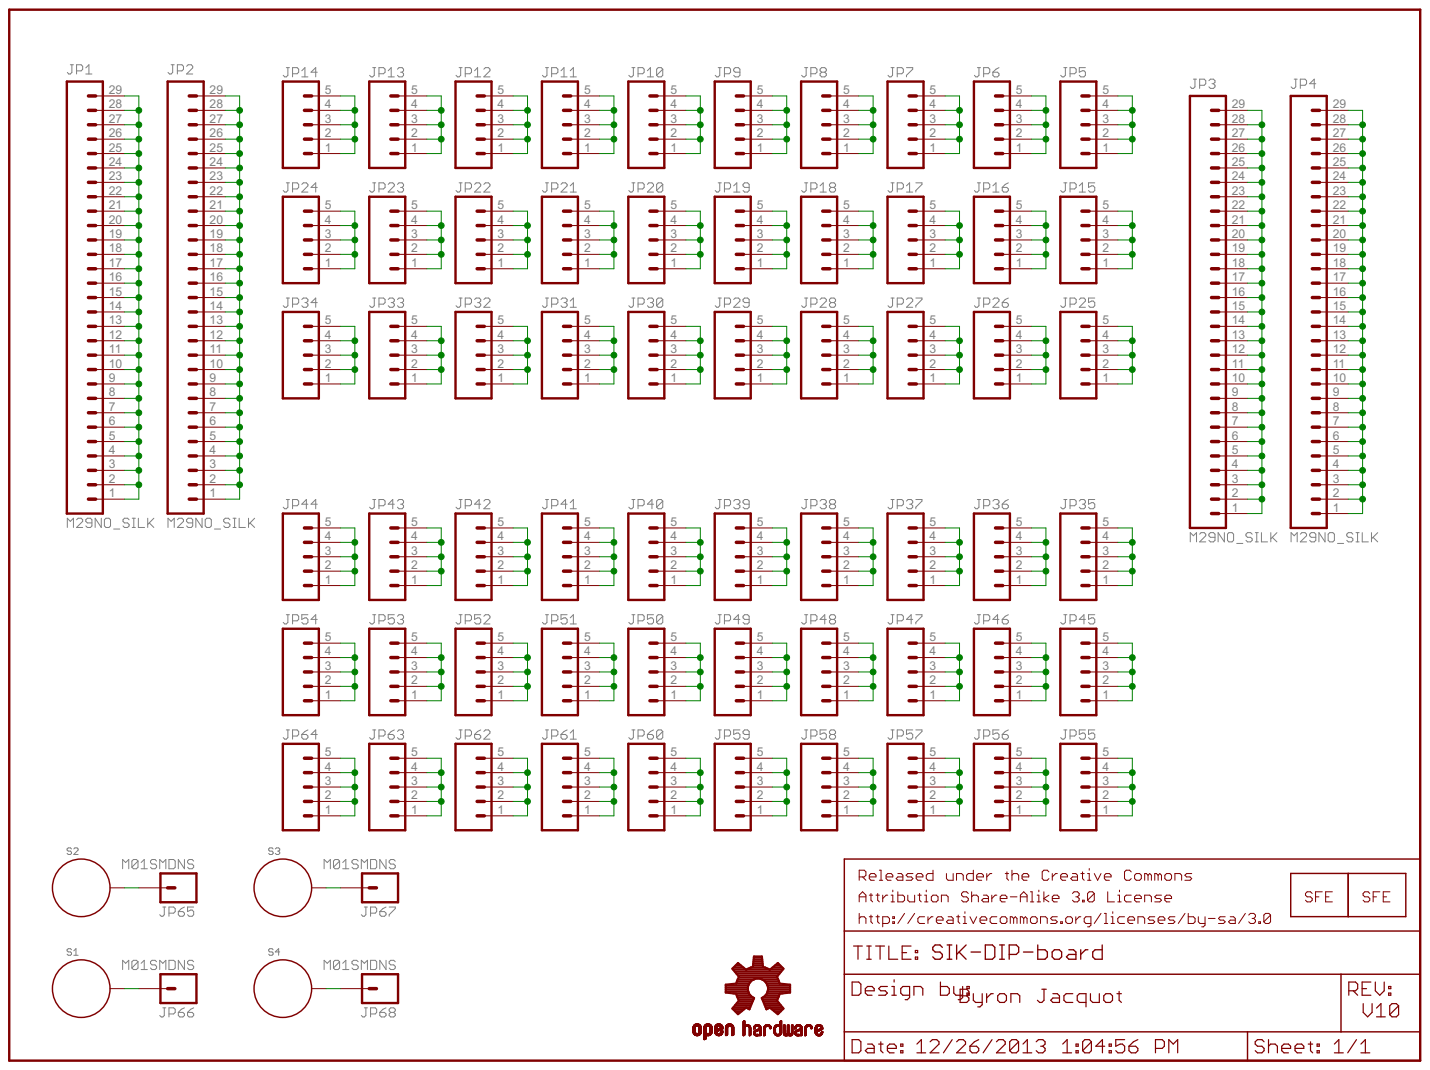
[picture p23: page 1]
