LearningByMaking/Hardware/AppBoard1.3/App_Board_V1.31.pdf

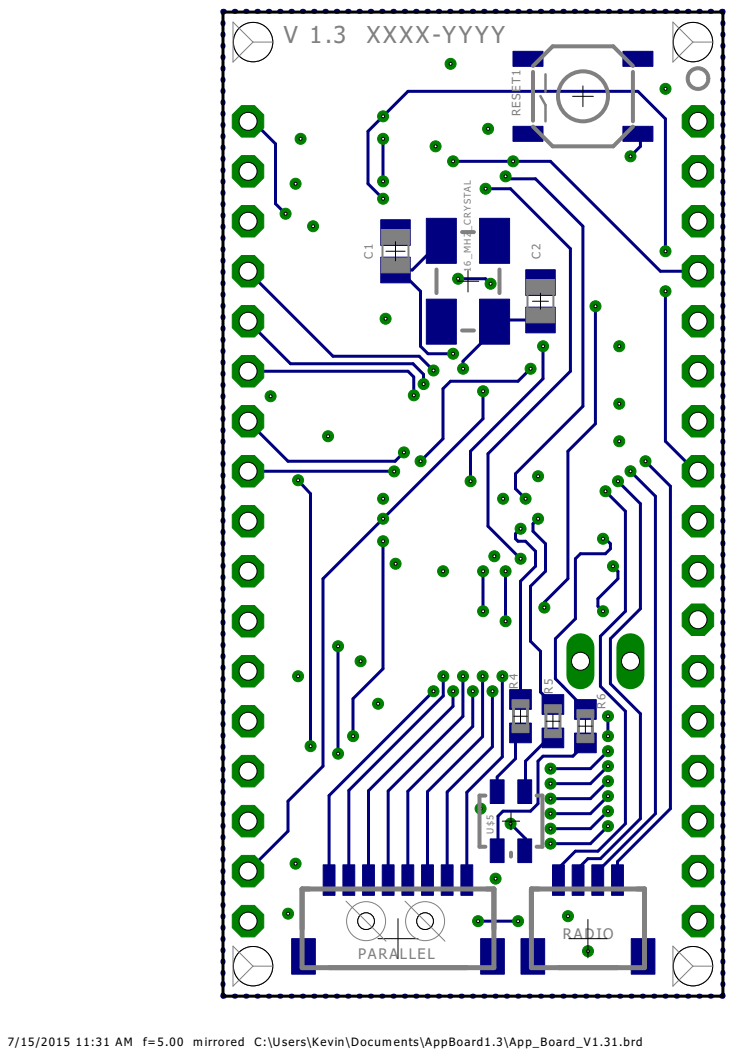
[picture p24: page 1]

7/15/2015 11:31 AM f=5.00 mirrored C:\Users\Kevin\Documents\AppBoard1.3\App_Board_V1.31.brd
