LearningByMaking/Hardware/AppBoard1.3/Bottom with part names.pdf

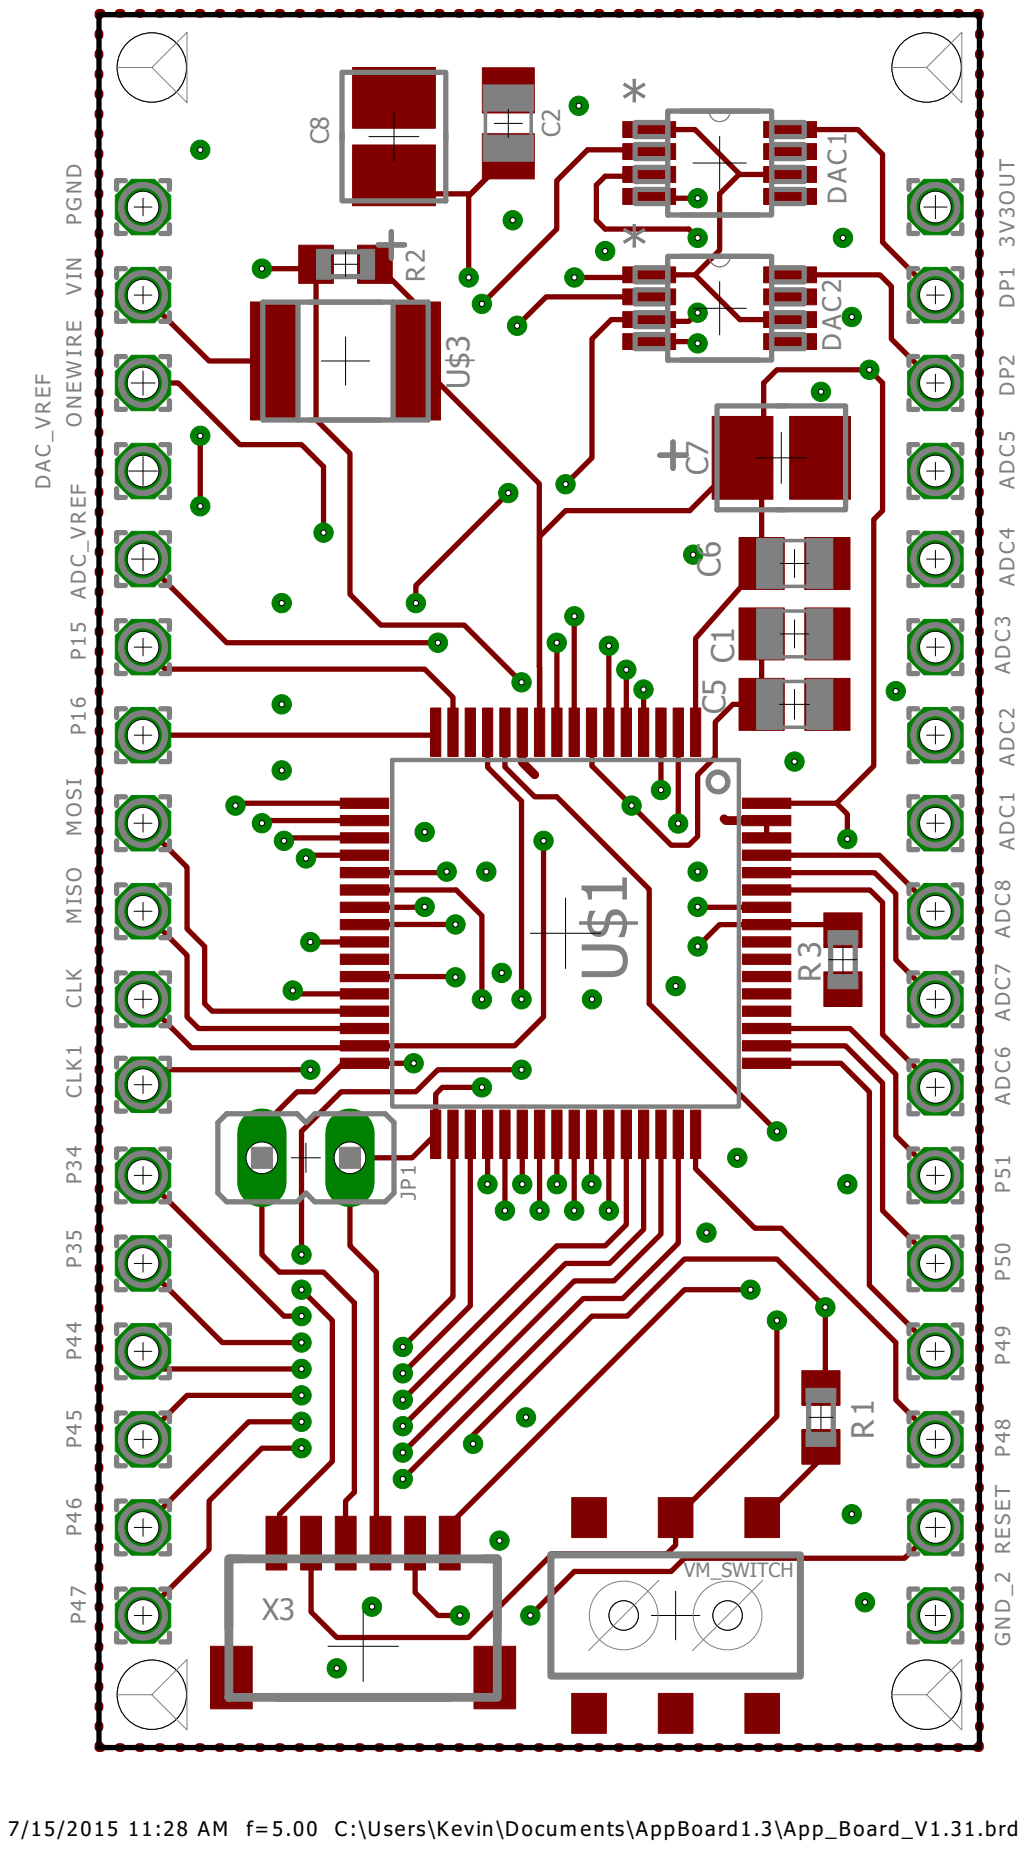
[picture p25: page 1]

7/15/2015 11:28 AM f=5.00 C:\Users\Kevin\Docum ents\AppBoard1.3\App_Board_V1.31.brd
