LearningByMaking/Hardware/AppBoard1.3/Top with part names.pdf

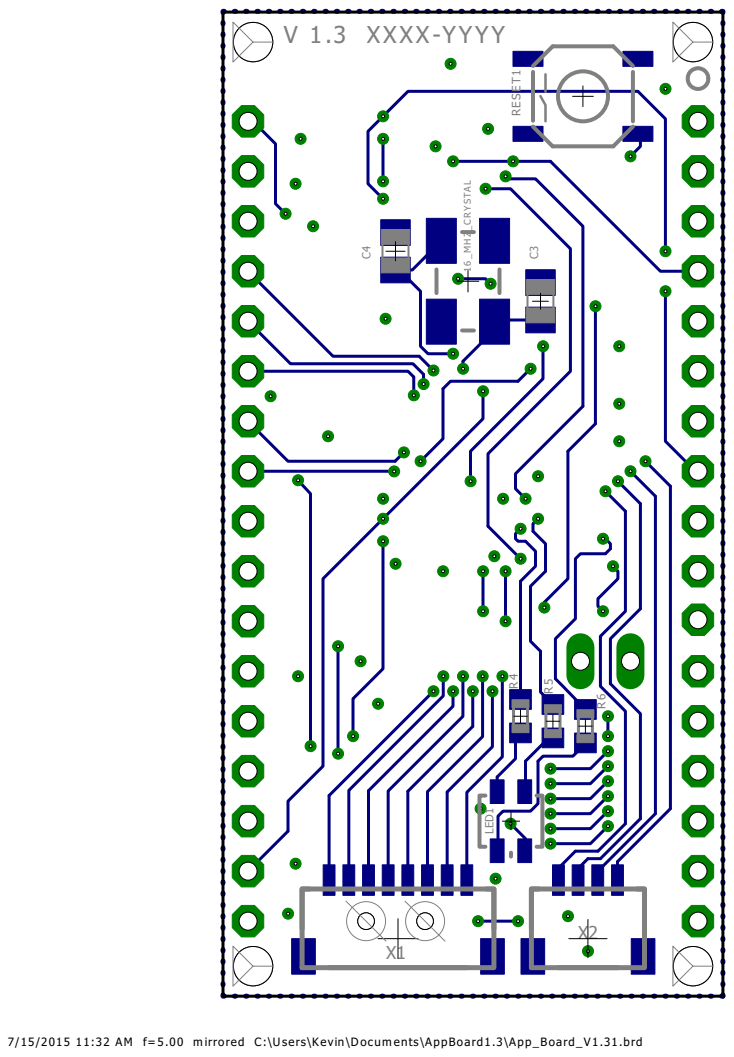
[picture p26: page 1]

7/15/2015 11:32 AM f=5.00 m irrored C:\Users\Kevin\Docum ents\AppBoard1.3\App_Board_V1.31.brd
