LearningByMaking/Hardware/FullProto/FullPrototypingBoard.brd

## EAGLE design FullProto/FullPrototypingBoard.brd (2016-07-07)

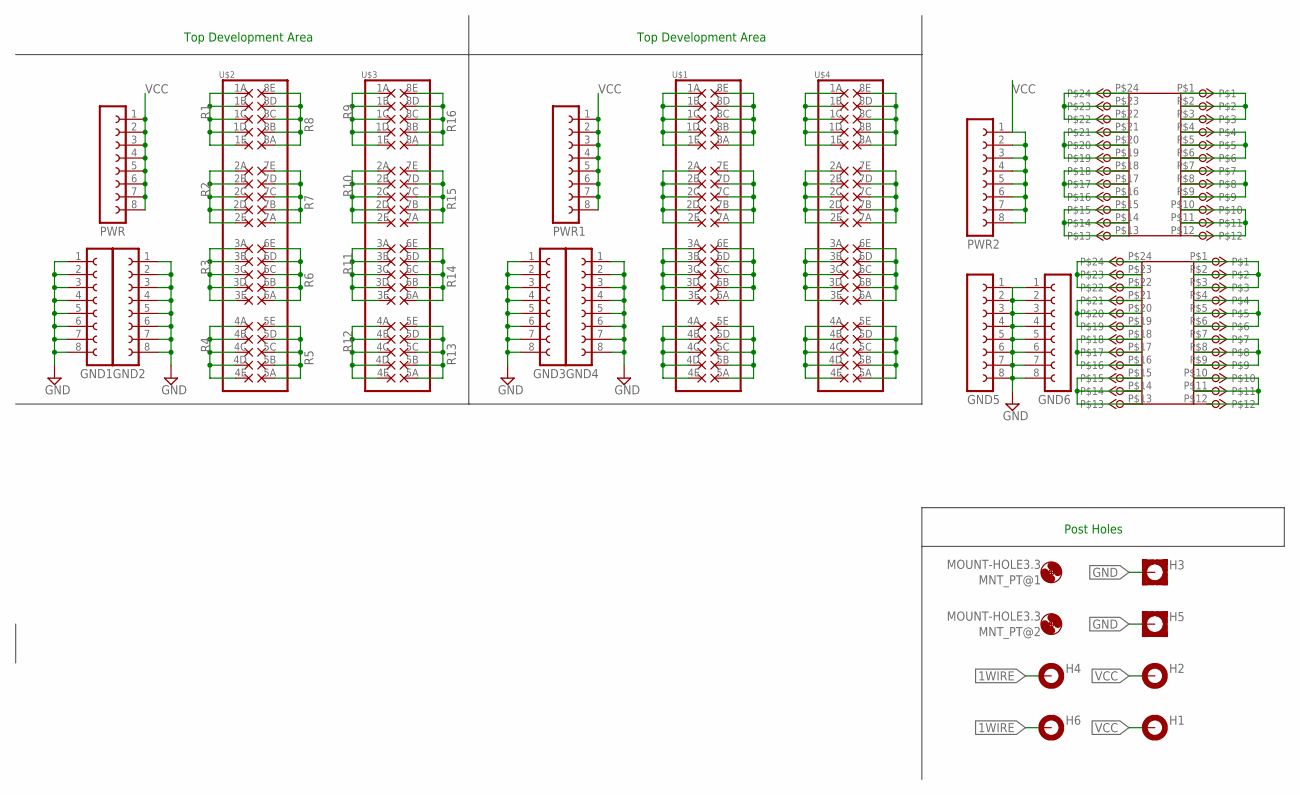
[picture p27: schematic FullPrototypingBoard.sch]

Parts:
GND1, GND2, GND3, GND4, GND5, GND6: FE08-GND
H1, H2, H4, H6: MOUNT-PAD-ROUND3.3; 3,3-PAD
H3, H5: MOUNT-PAD-SQUARE3.3; 3,3-PAD-SQUARE
MNT_PT@1, MNT_PT@2: MOUNT-HOLE3.3; 3,3
PWR, PWR1, PWR2: FE08
U$1, U$2, U$3, U$4: PROTO-5X8; PROTO-5X08
U$5, U$6: PROTO-3X8; PROTO-3X08

Connections:
1WIRE: H4.B3,3, H6.B3,3
GND: GND1.1, GND1.2, GND1.3, GND1.4, GND1.5, GND1.6, GND1.7, GND1.8, GND2.1, GND2.2, GND2.3, GND2.4, GND2.5, GND2.6, GND2.7, GND2.8, GND3.1, GND3.2, GND3.3, GND3.4, GND3.5, GND3.6, GND3.7, GND3.8, GND4.1, GND4.2, GND4.3, GND4.4, GND4.5, GND4.6, GND4.7, GND4.8, GND5.1, GND5.2, GND5.3, GND5.4, GND5.5, GND5.6, GND5.7, GND5.8, GND6.1, GND6.2, GND6.3, GND6.4, GND6.5, GND6.6, GND6.7, GND6.8, H3.B3,3, H5.B3,3
unnamed: U$5.P$22, U$5.P$23, U$5.P$24
unnamed: U$5.P$19, U$5.P$20, U$5.P$21
unnamed: U$5.P$16, U$5.P$17, U$5.P$18
unnamed: U$5.P$13, U$5.P$14, U$5.P$15
unnamed: U$5.P$1, U$5.P$2, U$5.P$3
unnamed: U$5.P$4, U$5.P$5, U$5.P$6
unnamed: U$5.P$7, U$5.P$8, U$5.P$9
unnamed: U$5.P$10, U$5.P$11
unnamed: U$6.P$22, U$6.P$23, U$6.P$24
unnamed: U$6.P$19, U$6.P$20, U$6.P$21
unnamed: U$6.P$16, U$6.P$17, U$6.P$18
unnamed: U$6.P$13, U$6.P$14, U$6.P$15
unnamed: U$6.P$1, U$6.P$2, U$6.P$3
unnamed: U$6.P$4, U$6.P$5, U$6.P$6
unnamed: U$6.P$7, U$6.P$8, U$6.P$9
unnamed: U$6.P$10, U$6.P$11
unnamed: U$1.1A, U$1.1B, U$1.1C, U$1.1D, U$1.1E
unnamed: U$1.8A, U$1.8B, U$1.8C, U$1.8D, U$1.8E
unnamed: U$1.7A, U$1.7B, U$1.7C, U$1.7D, U$1.7E
unnamed: U$1.2A, U$1.2B, U$1.2C, U$1.2D, U$1.2E
unnamed: U$1.6A, U$1.6B, U$1.6C, U$1.6D, U$1.6E
unnamed: U$1.3A, U$1.3B, U$1.3C, U$1.3D, U$1.3E
unnamed: U$1.5A, U$1.5B, U$1.5C, U$1.5D, U$1.5E
unnamed: U$1.4A, U$1.4B, U$1.4C, U$1.4D, U$1.4E
unnamed: U$4.8A, U$4.8B, U$4.8C, U$4.8D, U$4.8E
unnamed: U$4.1A, U$4.1B, U$4.1C, U$4.1D, U$4.1E
unnamed: U$4.7A, U$4.7B, U$4.7C, U$4.7D, U$4.7E
unnamed: U$4.2A, U$4.2B, U$4.2C, U$4.2D, U$4.2E
unnamed: U$4.6A, U$4.6B, U$4.6C, U$4.6D, U$4.6E
unnamed: U$4.3A, U$4.3B, U$4.3C, U$4.3D, U$4.3E
unnamed: U$4.5A, U$4.5B, U$4.5C, U$4.5D, U$4.5E
unnamed: U$4.4A, U$4.4B, U$4.4C, U$4.4D, U$4.4E
R1: U$2.1A, U$2.1B, U$2.1C, U$2.1D, U$2.1E
R2: U$2.2A, U$2.2B, U$2.2C, U$2.2D, U$2.2E
R3: U$2.3A, U$2.3B, U$2.3C, U$2.3D, U$2.3E
R4: U$2.4A, U$2.4B, U$2.4C, U$2.4D, U$2.4E
R5: U$2.5A, U$2.5B, U$2.5C, U$2.5D, U$2.5E
R6: U$2.6A, U$2.6B, U$2.6C, U$2.6D, U$2.6E
R7: U$2.7A, U$2.7B, U$2.7C, U$2.7D, U$2.7E
R8: U$2.8A, U$2.8B, U$2.8C, U$2.8D, U$2.8E
R9: U$3.1A, U$3.1B, U$3.1C, U$3.1D, U$3.1E
R10: U$3.2A, U$3.2B, U$3.2C, U$3.2D, U$3.2E
R11: U$3.3A, U$3.3B, U$3.3C, U$3.3D, U$3.3E
R12: U$3.4A, U$3.4B, U$3.4C, U$3.4D, U$3.4E
R13: U$3.5A, U$3.5B, U$3.5C, U$3.5D, U$3.5E
R14: U$3.6A, U$3.6B, U$3.6C, U$3.6D, U$3.6E
R15: U$3.7A, U$3.7B, U$3.7C, U$3.7D, U$3.7E
R16: U$3.8A, U$3.8B, U$3.8C, U$3.8D, U$3.8E
VCC: H1.B3,3, H2.B3,3, PWR.1, PWR.2, PWR.3, PWR.4, PWR.5, PWR.6, PWR.7, PWR.8, PWR1.1, PWR1.2, PWR1.3, PWR1.4, PWR1.5, PWR1.6, PWR1.7, PWR1.8, PWR2.1, PWR2.2, PWR2.3, PWR2.4, PWR2.5, PWR2.6, PWR2.7, PWR2.8

Notes on the sheet:
Post Holes
Top Development Area

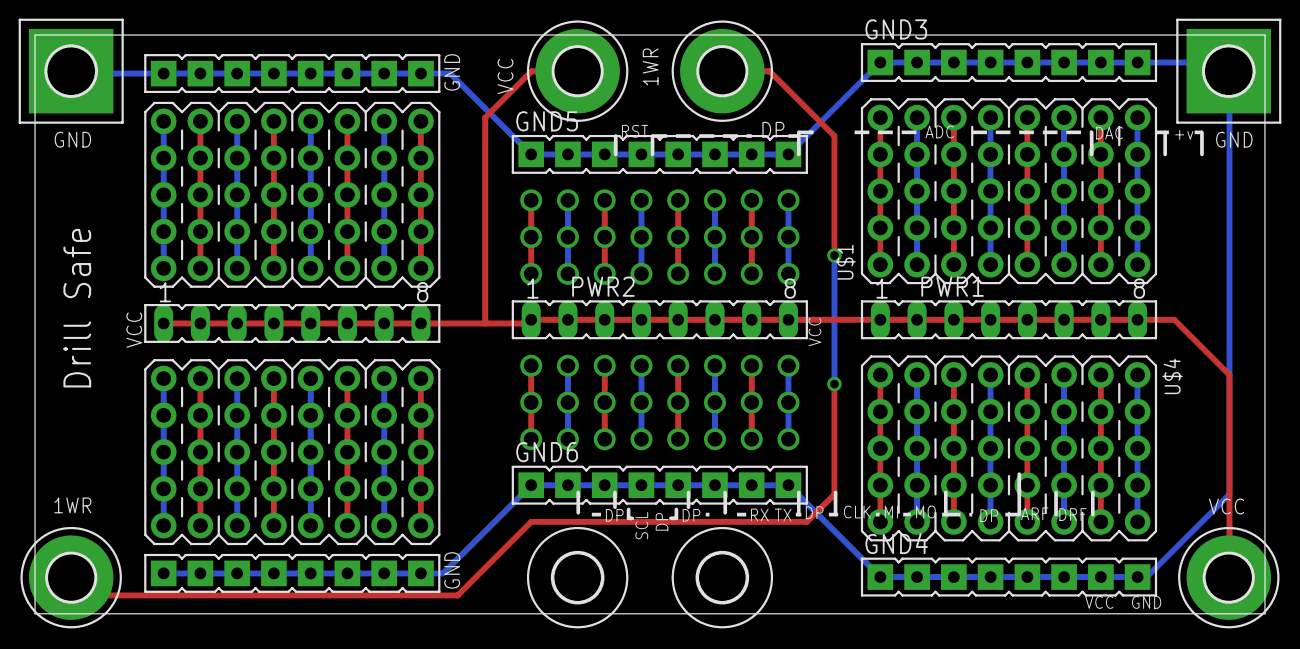
[picture p28: board FullPrototypingBoard.brd from above]

Board: 2 copper layers, 85.0 x 40.0 mm, 23 parts (0 on the bottom side), 51 nets.
