LearningByMaking/Hardware/uStar/uStar.brd

## EAGLE design uStar/uStar.brd (2016-07-07)

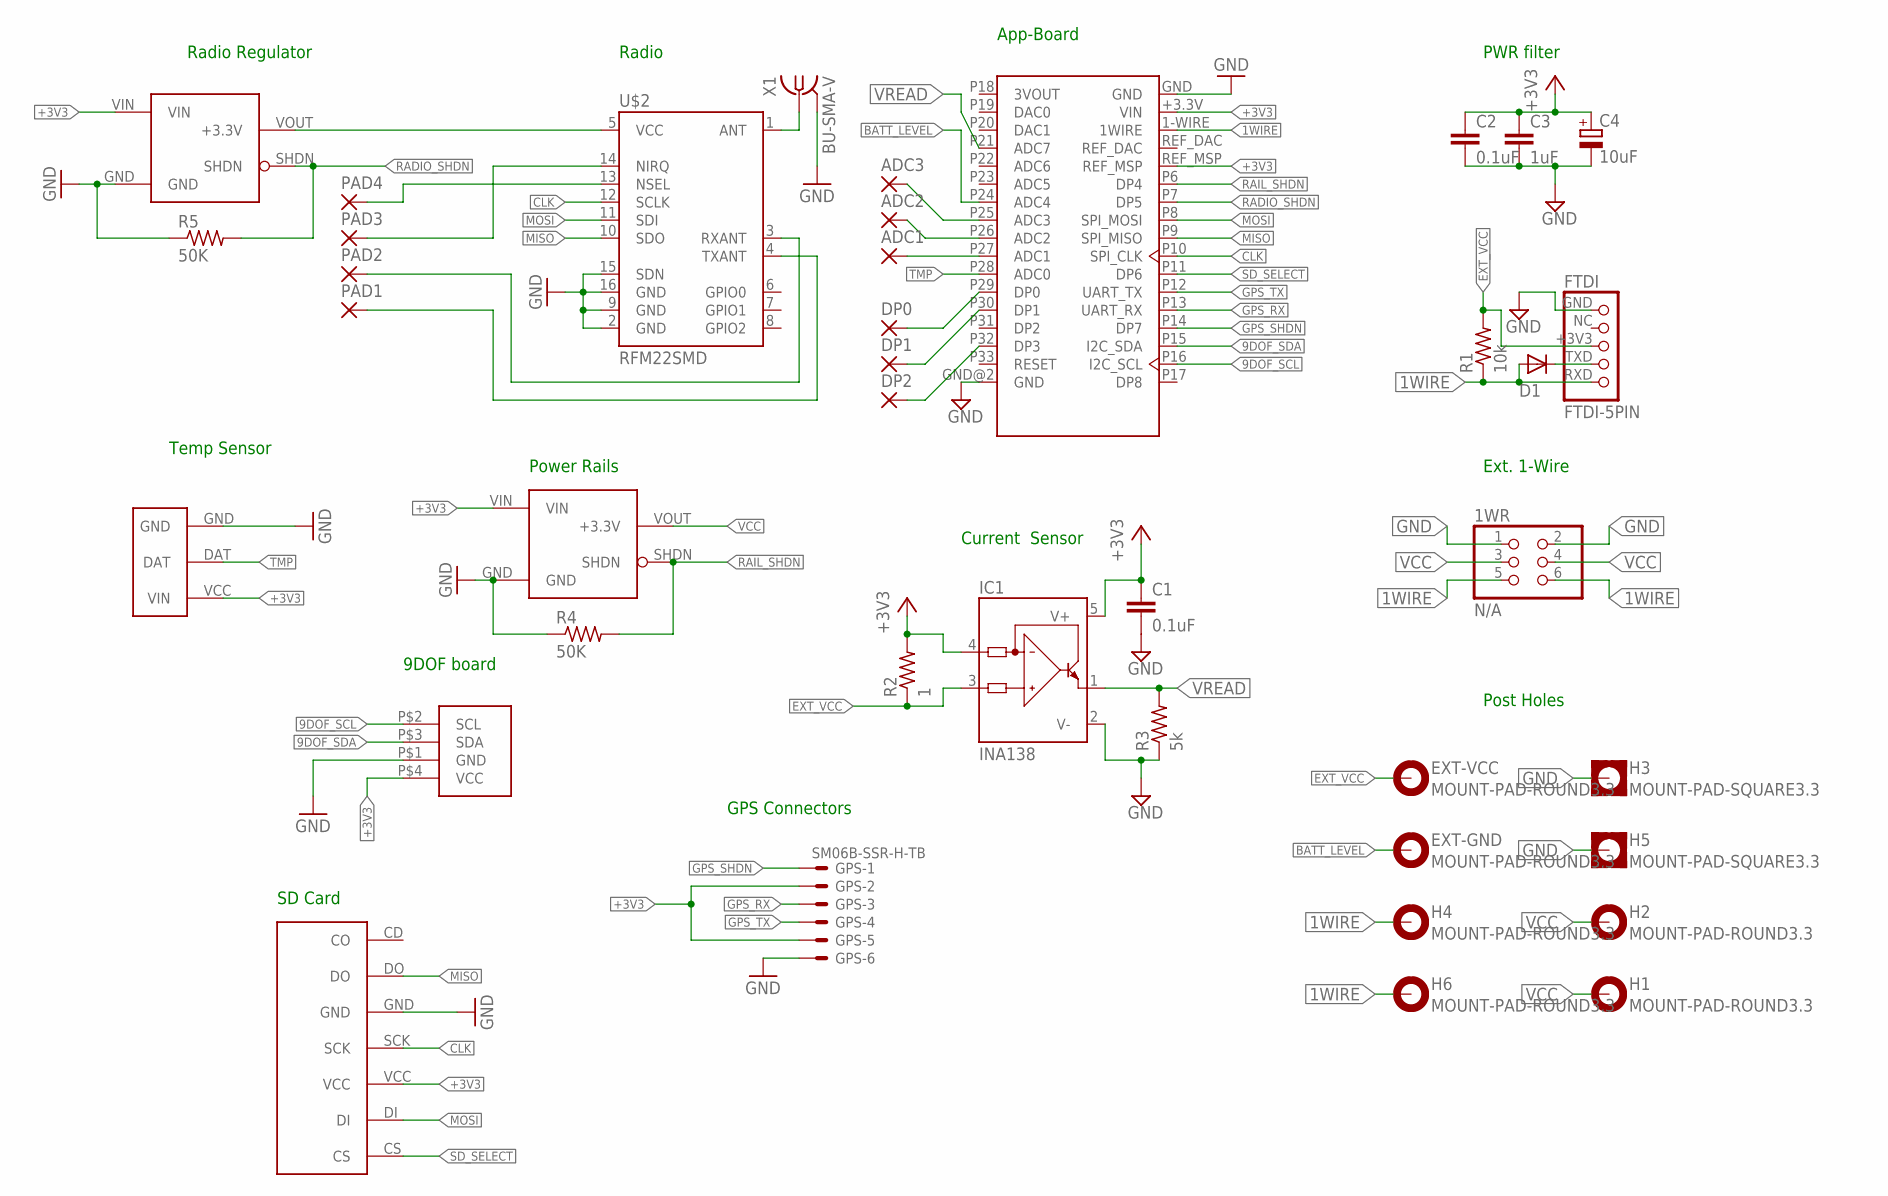
[picture p29: schematic uStar.sch]

Parts:
1WR: N/A; 2X03
ADC1, ADC2, ADC3: 1,6/0,9
C1: 0.1uF; C0805
C2: 0.1uF; C0603
C3: 1uF; C0603
C4: 10uF; SMC_B
D1: 1N4148DO35-7; DO35-7
DP0, DP1, DP2: 1,6/0,9
EXT-GND: MOUNT-PAD-ROUND3.3; 3,3-PAD
EXT-VCC: MOUNT-PAD-ROUND3.3; 3,3-PAD
FTDI: FTDI-5PIN; 1_05X2MM
GPS: SM06B-SSR-H-TB
H1, H2, H4, H6: MOUNT-PAD-ROUND3.3; 3,3-PAD
H3, H5: MOUNT-PAD-SQUARE3.3; 3,3-PAD-SQUARE
IC1: INA138; SOT23-5
PAD1, PAD2, PAD3, PAD4: 1,6/0,9
R1: 10k; 0207/7
R2: 1; R0603
R3: 5k; R0603
R4, R5: 50K; R0603
U$1: App-Board 1.2/1.3; APPCORE_RECEIVER
U$2: RFM22SMD; RFM22-XXX-S2
U$3, U$7: S7V8F3_VOLT_REG-3V3_1AHORZ-DOWN; S7V_DOWN
U$4: TMP_EXT
U$5: 9DOF
U$6: SDCARD_EXT
X1: BU-SMA-V

Connections:
1WIRE: 1WR.5, 1WR.6, D1.A, FTDI.RXD, H4.B3,3, H6.B3,3, R1.1, U$1.1-WIRE (1WIRE)
9DOF_SCL: U$1.P16 (I2C_SCL), U$5.P$2 (SCL)
9DOF_SDA: U$1.P15 (I2C_SDA), U$5.P$3 (SDA)
+3V3: C1.1, C2.1, C3.1, C4.+, GPS.2, GPS.5, IC1.4 (IN-), IC1.5 (V+), R2.2, U$1.+3.3V (VIN), U$1.REF_MSP, U$3.VIN, U$4.VCC (VIN), U$5.P$4 (VCC), U$6.VCC, U$7.VIN
BATT_LEVEL: EXT-GND.B3,3, U$1.P24 (ADC4)
CLK: U$1.P10 (SPI_CLK), U$2.12 (SCLK), U$6.SCK
EXT_VCC: EXT-VCC.B3,3, FTDI.+3V3, IC1.3 (IN+), R1.2, R2.1
GND: 1WR.1, 1WR.2, C1.2, C2.2, C3.2, C4.-, FTDI.GND, GPS.6, H3.B3,3, H5.B3,3, IC1.2 (V-), R3.1, R4.1, R5.1, U$1.GND, U$1.GND@2 (GND), U$2.2 (GND), U$2.9 (GND), U$2.15 (SDN), U$2.16 (GND), U$3.GND, U$4.GND, U$5.P$1 (GND), U$6.GND, U$7.GND, X1.2, X1.3 (2), X1.4 (2), X1.5 (2)
GPS_RX: GPS.3, U$1.P13 (UART_RX)
GPS_SHDN: GPS.1, U$1.P14 (DP7)
GPS_TX: GPS.4, U$1.P12 (UART_TX)
MISO: U$1.P9 (SPI_MISO), U$2.10 (SDO), U$6.DO
MOSI: U$1.P8 (SPI_MOSI), U$2.11 (SDI), U$6.DI
unnamed: PAD1.1, U$2.4 (TXANT)
unnamed: PAD2.1, U$2.3 (RXANT)
unnamed: D1.C, FTDI.TXD
unnamed: PAD3.1, U$2.14 (NIRQ)
unnamed: PAD4.1, U$2.13 (NSEL)
unnamed: U$2.1 (ANT), X1.1
unnamed: U$2.5 (VCC), U$3.VOUT (+3.3V)
unnamed: ADC1.1, U$1.P27 (ADC1)
unnamed: ADC2.1, U$1.P26 (ADC2)
unnamed: ADC3.1, U$1.P25 (ADC3)
unnamed: DP0.1, U$1.P29 (DP0)
unnamed: DP1.1, U$1.P30 (DP1)
unnamed: DP2.1, U$1.P32 (DP3)
RADIO_SHDN: R5.2, U$1.P7 (DP5), U$3.SHDN
RAIL_SHDN: R4.2, U$1.P6 (DP4), U$7.SHDN
SD_SELECT: U$1.P11 (DP6), U$6.CS
TMP: U$1.P28 (ADC0), U$4.DAT
VCC: 1WR.3, 1WR.4, H1.B3,3, H2.B3,3, U$7.VOUT (+3.3V)
VREAD: IC1.1 (OUT), R3.2, U$1.P21 (ADC7)

Notes on the sheet:
Post Holes
Ext. 1-Wire
App-Board
PWR filter
Current Sensor
Radio
Radio Regulator
Temp Sensor
9DOF board
GPS Connectors
SD Card
Power Rails

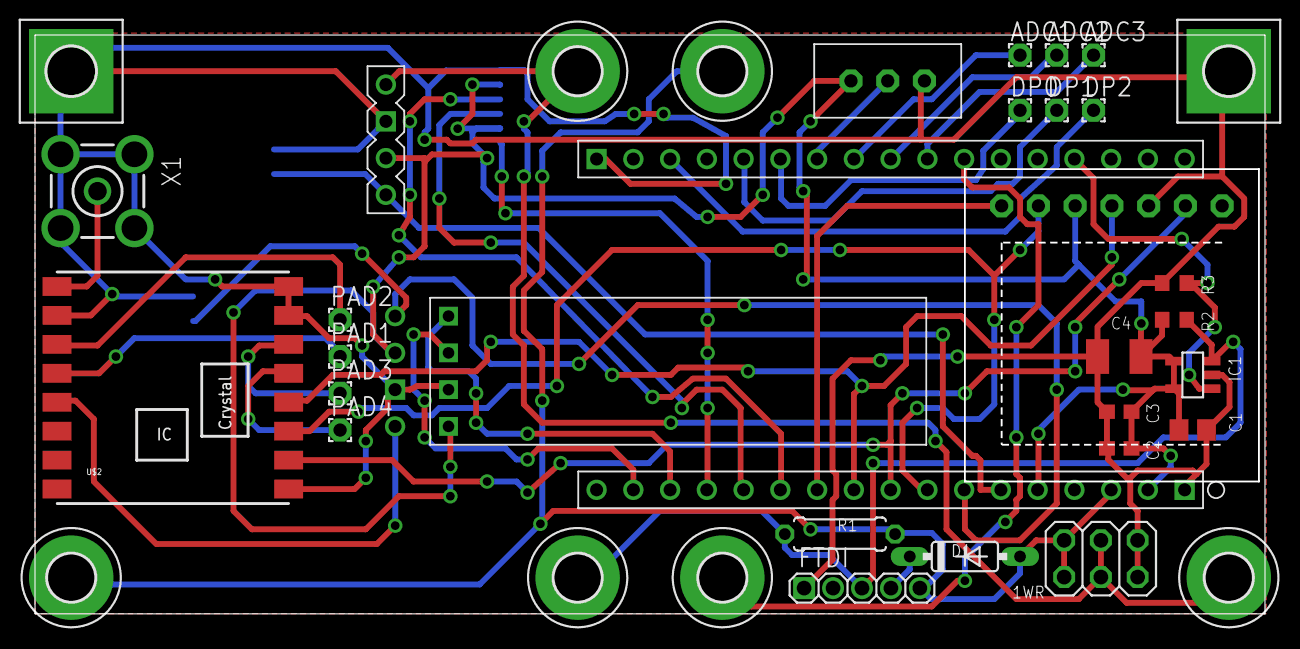
[picture p30: board uStar.brd from above]

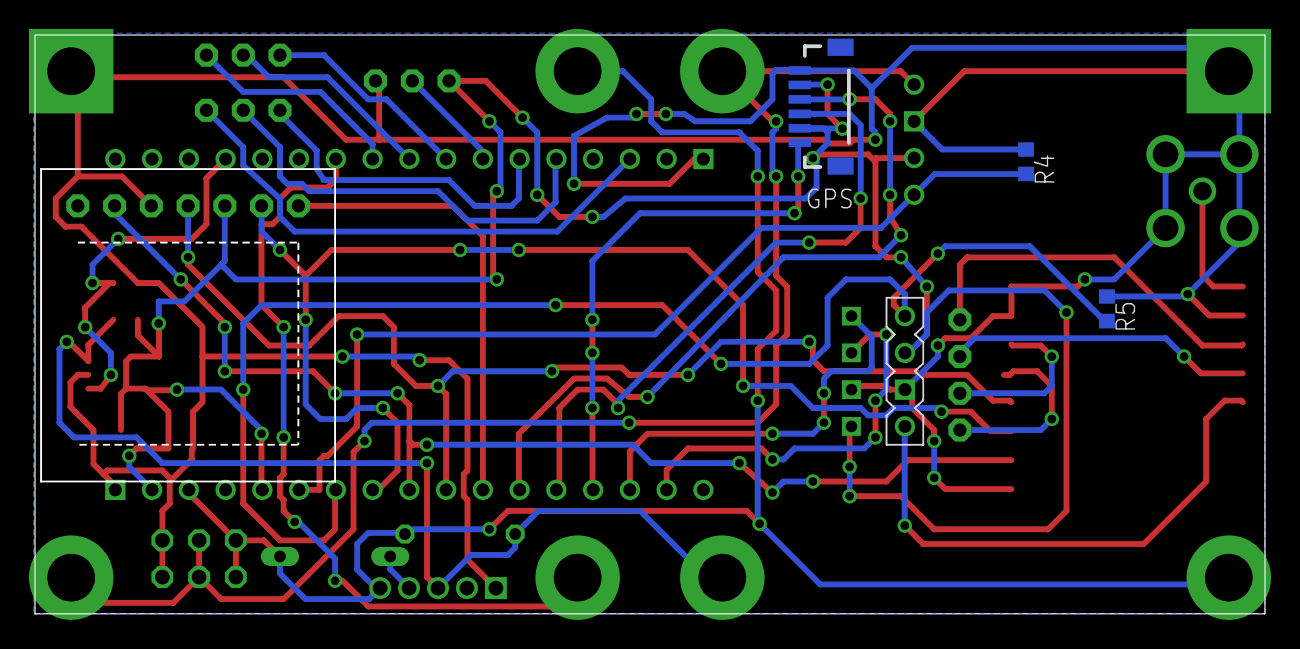
[picture p31: board uStar.brd from below]

Board: 2 copper layers, 85.0 x 40.0 mm, 40 parts (5 on the bottom side), 32 nets.
