LearningByMaking/Hardware/Protoboard/Protoboard.brd

## EAGLE design Protoboard/Protoboard.brd (2016-06-02)

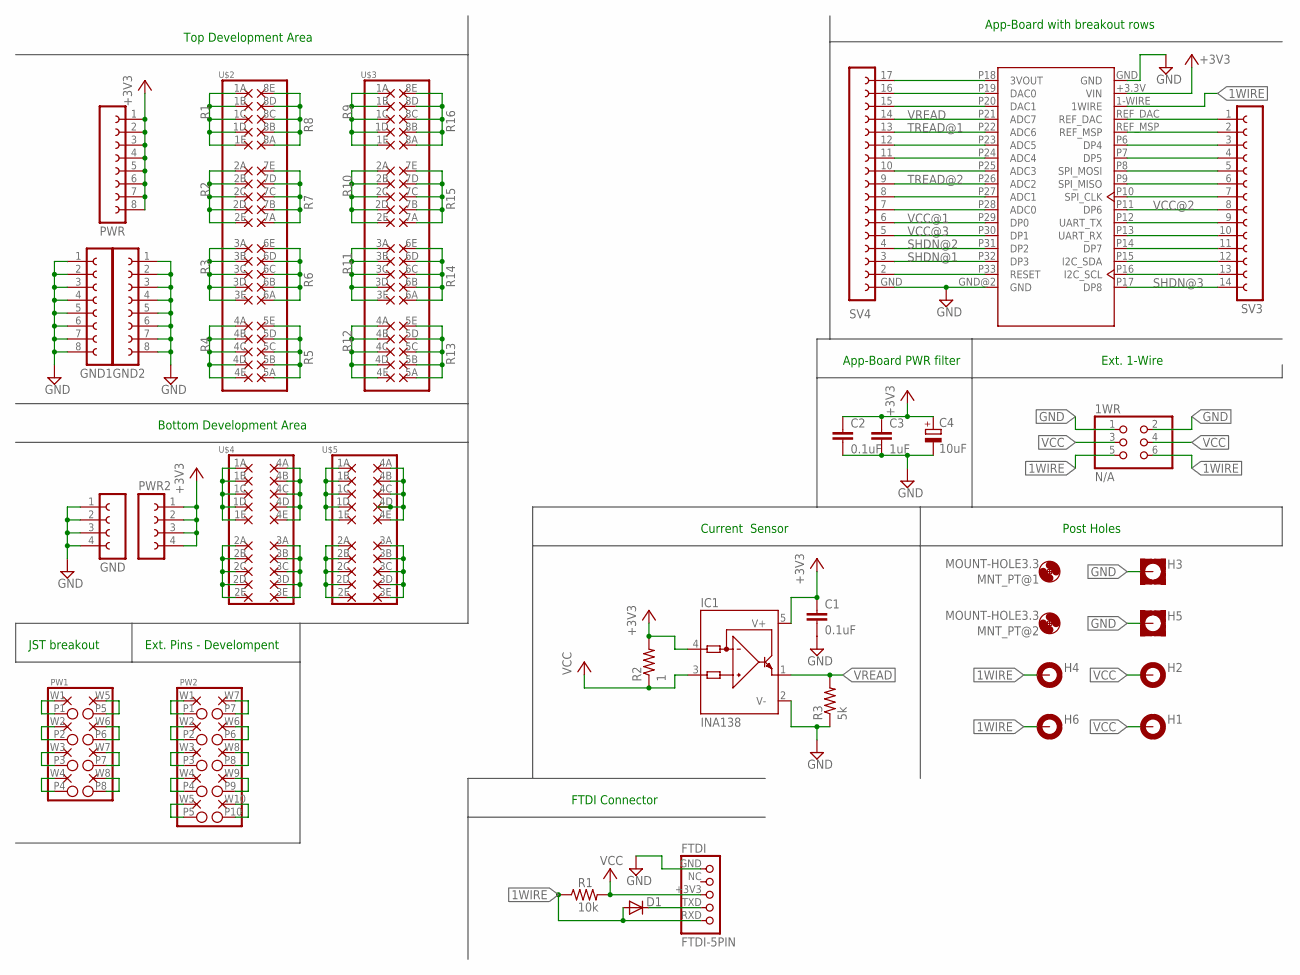
[picture p32: schematic Protoboard.sch]

Parts:
1WR: N/A; 2X03
C1, C2: 0.1uF; C0603
C3: 1uF; C0603
C4: 10uF; SMC_B
D1: 1N4148DO35-7; DO35-7
FTDI: FTDI-5PIN; 1X05
GND: FE04-GND
GND1, GND2: FE08-GND
H1, H2, H4, H6: MOUNT-PAD-ROUND3.3; 3,3-PAD
H3, H5: MOUNT-PAD-SQUARE3.3; 3,3-PAD-SQUARE
IC1: INA138; SOT23-5
MNT_PT@1, MNT_PT@2: MOUNT-HOLE3.3; 3,3
PW1: PIN-WIRE-2X8; 2X8
PW2: PIN-WIRE-2X10; 2X10
PWR: FE08
PWR2: FE04-1
R1: 10k; 0204/5
R2: 1; R0603
R3: 5k; R0805
SV3: FE14-1_ABBO
SV4: FE17-1_ABBO
U$1: App-Board 1.2/1.3; APPCORE_RECEIVER
U$2, U$3: PROTO-5X8; PROTO-5X08
U$4, U$5: PROTO-4X5; PROTO-4X05

Connections:
1WIRE: 1WR.5, 1WR.6, D1.A, FTDI.RXD, H4.B3,3, H6.B3,3, R1.1, U$1.1-WIRE (1WIRE)
+3V3: C1.1, C2.1, C3.1, C4.+, IC1.4 (IN-), IC1.5 (V+), PWR.1, PWR.2, PWR.3, PWR.4, PWR.5, PWR.6, PWR.7, PWR.8, PWR2.1, PWR2.2, PWR2.3, PWR2.4, R2.2, U$1.+3.3V (VIN)
GND: 1WR.1, 1WR.2, C1.2, C2.2, C3.2, C4.-, FTDI.GND, GND.1, GND.2, GND.3, GND.4, GND1.1, GND1.2, GND1.3, GND1.4, GND1.5, GND1.6, GND1.7, GND1.8, GND2.1, GND2.2, GND2.3, GND2.4, GND2.5, GND2.6, GND2.7, GND2.8, H3.B3,3, H5.B3,3, IC1.2 (V-), R3.1, SV4.GND, U$1.GND, U$1.GND@2 (GND)
unnamed: U$4.1A, U$4.1B, U$4.1C, U$4.1D, U$4.1E
unnamed: PW1.P1, PW1.W1
unnamed: D1.C, FTDI.TXD
unnamed: PW1.P2, PW1.W2
unnamed: U$4.4A, U$4.4B, U$4.4C, U$4.4D, U$4.4E
unnamed: U$4.2A, U$4.2B, U$4.2C, U$4.2D, U$4.2E
unnamed: U$4.3A, U$4.3B, U$4.3C, U$4.3D, U$4.3E
unnamed: U$5.1A, U$5.1B, U$5.1C, U$5.1D, U$5.1E
unnamed: U$5.4A, U$5.4B, U$5.4C, U$5.4D, U$5.4E
unnamed: U$5.2A, U$5.2B, U$5.2C, U$5.2D, U$5.2E
unnamed: U$5.3A, U$5.3B, U$5.3C, U$5.3D, U$5.3E
unnamed: PW2.P1, PW2.W1
unnamed: PW2.P2, PW2.W2
unnamed: PW2.P3, PW2.W3
unnamed: PW2.P4, PW2.W4
unnamed: PW2.P5, PW2.W5
unnamed: PW2.P7, PW2.W7
unnamed: PW2.P6, PW2.W6
unnamed: PW2.P8, PW2.W8
unnamed: PW2.P9, PW2.W9
unnamed: PW2.P10, PW2.W10
unnamed: SV3.1, U$1.REF_DAC
unnamed: SV3.2, U$1.REF_MSP
unnamed: SV3.3, U$1.P6 (DP4)
unnamed: SV3.4, U$1.P7 (DP5)
unnamed: SV3.5, U$1.P8 (SPI_MOSI)
unnamed: SV3.6, U$1.P9 (SPI_MISO)
unnamed: SV3.7, U$1.P10 (SPI_CLK)
unnamed: SV3.9, U$1.P12 (UART_TX)
unnamed: SV3.10, U$1.P13 (UART_RX)
unnamed: SV3.11, U$1.P14 (DP7)
unnamed: SV3.12, U$1.P15 (I2C_SDA)
unnamed: SV3.13, U$1.P16 (I2C_SCL)
unnamed: SV4.17, U$1.P18 (3VOUT)
unnamed: SV4.16, U$1.P19 (DAC0)
unnamed: SV4.15, U$1.P20 (DAC1)
unnamed: SV4.12, U$1.P23 (ADC5)
unnamed: SV4.11, U$1.P24 (ADC4)
unnamed: SV4.10, U$1.P25 (ADC3)
unnamed: SV4.8, U$1.P27 (ADC1)
unnamed: SV4.7, U$1.P28 (ADC0)
unnamed: PW1.P3, PW1.W3
unnamed: PW1.P4, PW1.W4
unnamed: PW1.P5, PW1.W5
unnamed: PW1.P6, PW1.W6
unnamed: PW1.P7, PW1.W7
unnamed: PW1.P8, PW1.W8
R1: U$2.1A, U$2.1B, U$2.1C, U$2.1D, U$2.1E
R2: U$2.2A, U$2.2B, U$2.2C, U$2.2D, U$2.2E
R3: U$2.3A, U$2.3B, U$2.3C, U$2.3D, U$2.3E
R4: U$2.4A, U$2.4B, U$2.4C, U$2.4D, U$2.4E
R5: U$2.5A, U$2.5B, U$2.5C, U$2.5D, U$2.5E
R6: U$2.6A, U$2.6B, U$2.6C, U$2.6D, U$2.6E
R7: U$2.7A, U$2.7B, U$2.7C, U$2.7D, U$2.7E
R8: U$2.8A, U$2.8B, U$2.8C, U$2.8D, U$2.8E
R9: U$3.1A, U$3.1B, U$3.1C, U$3.1D, U$3.1E
R10: U$3.2A, U$3.2B, U$3.2C, U$3.2D, U$3.2E
R11: U$3.3A, U$3.3B, U$3.3C, U$3.3D, U$3.3E
R12: U$3.4A, U$3.4B, U$3.4C, U$3.4D, U$3.4E
R13: U$3.5A, U$3.5B, U$3.5C, U$3.5D, U$3.5E
R14: U$3.6A, U$3.6B, U$3.6C, U$3.6D, U$3.6E
R15: U$3.7A, U$3.7B, U$3.7C, U$3.7D, U$3.7E
R16: U$3.8A, U$3.8B, U$3.8C, U$3.8D, U$3.8E
RESET: SV4.2, U$1.P33 (RESET)
SHDN@1: SV4.3, U$1.P32 (DP3)
SHDN@2: SV4.4, U$1.P31 (DP2)
SHDN@3: SV3.14, U$1.P17 (DP8)
TREAD@1: SV4.13, U$1.P22 (ADC6)
TREAD@2: SV4.9, U$1.P26 (ADC2)
VCC: 1WR.3, 1WR.4, FTDI.+3V3, H1.B3,3, H2.B3,3, IC1.3 (IN+), R1.2, R2.1
VCC@1: SV4.6, U$1.P29 (DP0)
VCC@2: SV3.8, U$1.P11 (DP6)
VCC@3: SV4.5, U$1.P30 (DP1)
VREAD: IC1.1 (OUT), R3.2, SV4.14, U$1.P21 (ADC7)

Notes on the sheet:
Post Holes
Ext. 1-Wire
App-Board with breakout rows
App-Board PWR filter
Current Sensor
FTDI Connector
JST breakout
Ext. Pins - Develompent
Bottom Development Area
Top Development Area

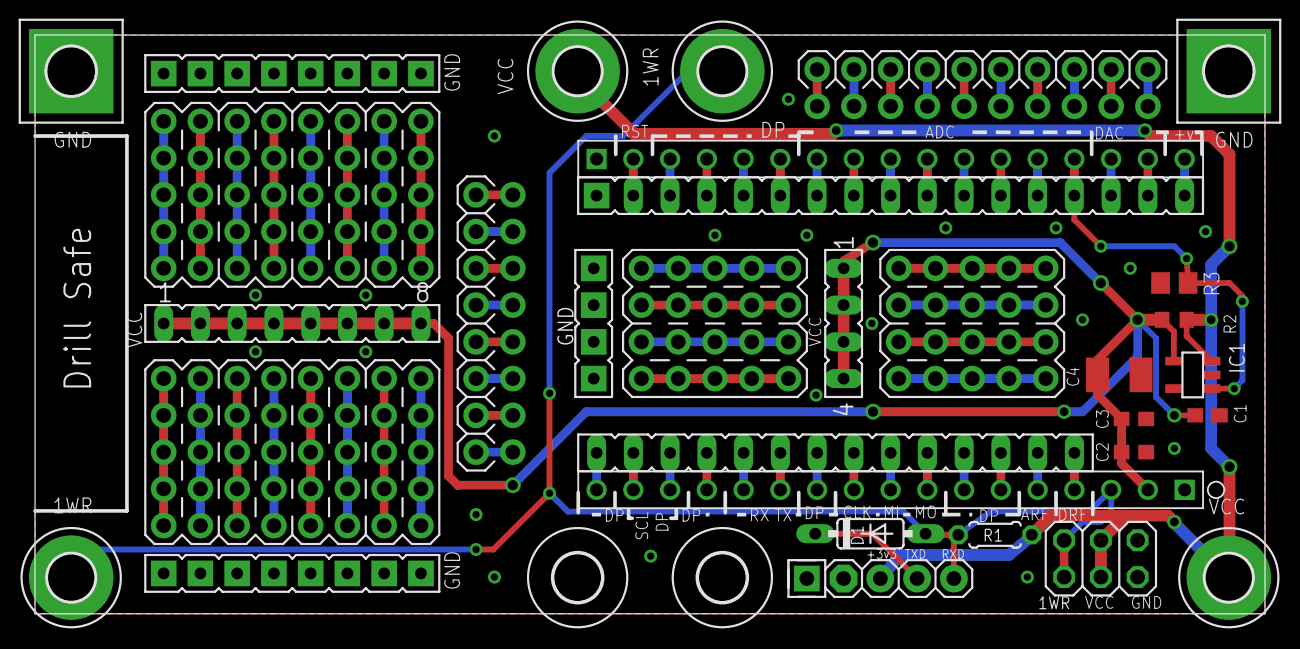
[picture p33: board Protoboard.brd from above]

Board: 2 copper layers, 85.0 x 40.0 mm, 33 parts (0 on the bottom side), 77 nets.
