LearningByMaking/Hardware/Protoboard/Docs/Solder-able_Breadboard/Solder-able_Breadboard-master/hardware/SIK-DIP-board.brd

## EAGLE design Protoboard/Docs/Solder-able_Breadboard/Solder-able_Breadboard-master/hardware/SIK-DIP-board.brd (2016-04-11)

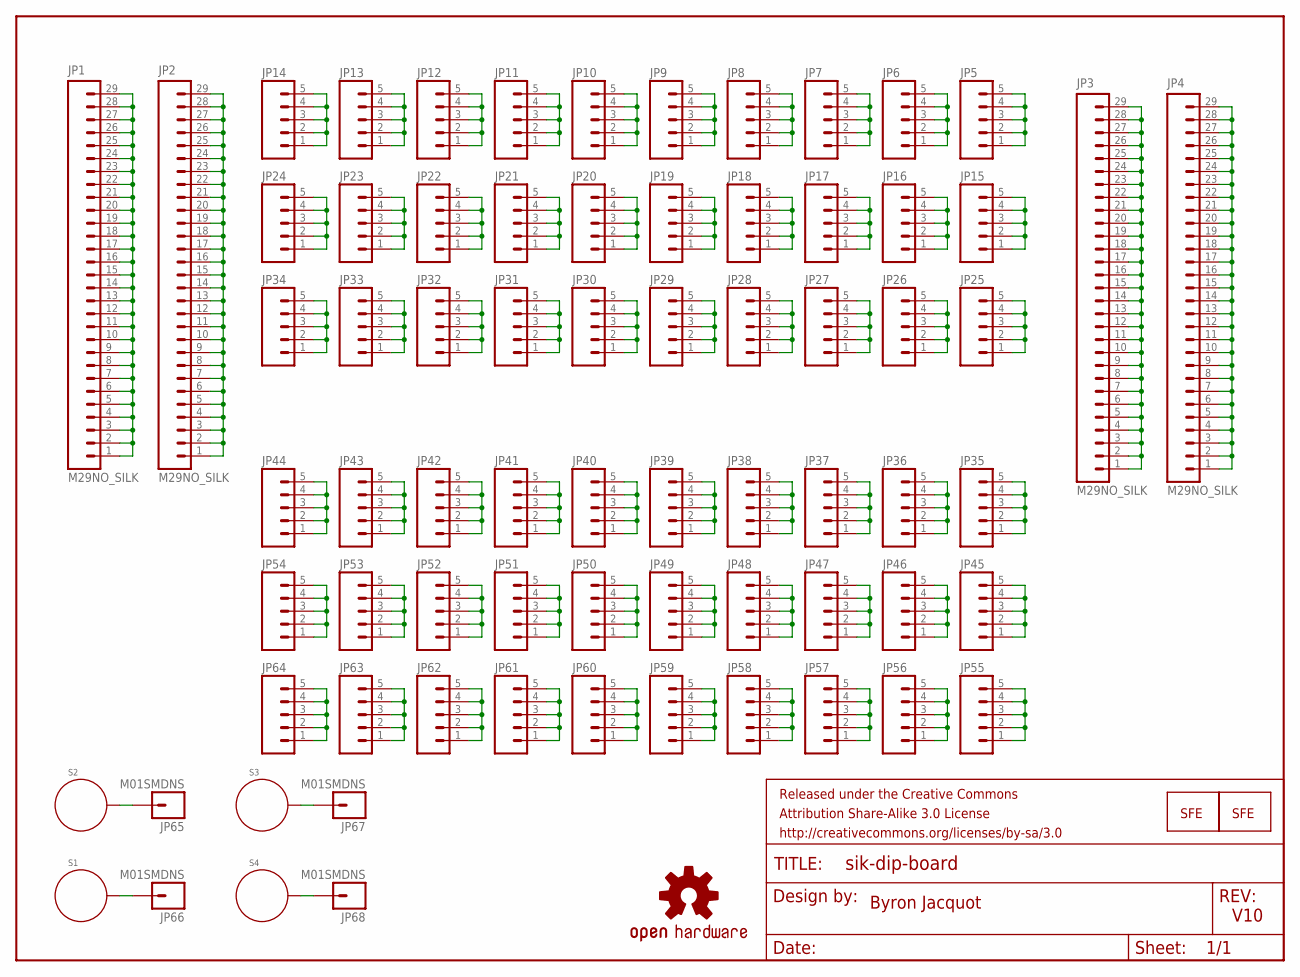
[picture p34: schematic SIK-DIP-board.sch]

Parts:
FRAME1: FRAME-LETTER; CREATIVE_COMMONS
JP1, JP2, JP3, JP4: M29NO_SILK; 1X29_NO_SILK
JP5, JP6, JP7, JP8, JP9, JP10, JP11, JP12, JP13, JP14, JP15, JP16, JP17, JP18, JP19, JP20, JP21, JP22, JP23, JP24, JP25, JP26, JP27, JP28, JP29, JP30, JP31, JP32, JP33, JP34, JP35, JP36, JP37, JP38, JP39, JP40, JP41, JP42, JP43, JP44, JP45, JP46, JP47, JP48, JP49, JP50, JP51, JP52, JP53, JP54, JP55, JP56, JP57, JP58, JP59, JP60, JP61, JP62, JP63, JP64: M05NO_SILK; 1X05_NO_SILK
JP65, JP66, JP67, JP68: M01SMDNS; 1X01NS
LOGO1: LOGO-SFECP; SFE-LOGO-FLAME-COPPER
LOGO2: LOGO-SFENEW; SFE-NEW-WEBLOGO
LOGO3: OSHW-LOGOS; OSHW-LOGO-S
S1, S2, S3, S4: STANDOFF_ELECTRICAL; STANDOFF-ELECTRICAL

Connections:
unnamed: JP1.1, JP1.2, JP1.3, JP1.4, JP1.5, JP1.6, JP1.7, JP1.8, JP1.9, JP1.10, JP1.11, JP1.12, JP1.13, JP1.14, JP1.15, JP1.16, JP1.17, JP1.18, JP1.19, JP1.20, JP1.21, JP1.22, JP1.23, JP1.24, JP1.25, JP1.26, JP1.27, JP1.28, JP1.29
unnamed: JP2.1, JP2.2, JP2.3, JP2.4, JP2.5, JP2.6, JP2.7, JP2.8, JP2.9, JP2.10, JP2.11, JP2.12, JP2.13, JP2.14, JP2.15, JP2.16, JP2.17, JP2.18, JP2.19, JP2.20, JP2.21, JP2.22, JP2.23, JP2.24, JP2.25, JP2.26, JP2.27, JP2.28, JP2.29
unnamed: JP3.1, JP3.2, JP3.3, JP3.4, JP3.5, JP3.6, JP3.7, JP3.8, JP3.9, JP3.10, JP3.11, JP3.12, JP3.13, JP3.14, JP3.15, JP3.16, JP3.17, JP3.18, JP3.19, JP3.20, JP3.21, JP3.22, JP3.23, JP3.24, JP3.25, JP3.26, JP3.27, JP3.28, JP3.29
unnamed: JP4.1, JP4.2, JP4.3, JP4.4, JP4.5, JP4.6, JP4.7, JP4.8, JP4.9, JP4.10, JP4.11, JP4.12, JP4.13, JP4.14, JP4.15, JP4.16, JP4.17, JP4.18, JP4.19, JP4.20, JP4.21, JP4.22, JP4.23, JP4.24, JP4.25, JP4.26, JP4.27, JP4.28, JP4.29
unnamed: JP10.1, JP10.2, JP10.3, JP10.4, JP10.5
unnamed: JP5.1, JP5.2, JP5.3, JP5.4, JP5.5
unnamed: JP6.1, JP6.2, JP6.3, JP6.4, JP6.5
unnamed: JP7.1, JP7.2, JP7.3, JP7.4, JP7.5
unnamed: JP8.1, JP8.2, JP8.3, JP8.4, JP8.5
unnamed: JP9.1, JP9.2, JP9.3, JP9.4, JP9.5
unnamed: JP11.1, JP11.2, JP11.3, JP11.4, JP11.5
unnamed: JP12.1, JP12.2, JP12.3, JP12.4, JP12.5
unnamed: JP13.1, JP13.2, JP13.3, JP13.4, JP13.5
unnamed: JP14.1, JP14.2, JP14.3, JP14.4, JP14.5
unnamed: JP15.1, JP15.2, JP15.3, JP15.4, JP15.5
unnamed: JP16.1, JP16.2, JP16.3, JP16.4, JP16.5
unnamed: JP17.1, JP17.2, JP17.3, JP17.4, JP17.5
unnamed: JP18.1, JP18.2, JP18.3, JP18.4, JP18.5
unnamed: JP19.1, JP19.2, JP19.3, JP19.4, JP19.5
unnamed: JP20.1, JP20.2, JP20.3, JP20.4, JP20.5
unnamed: JP21.1, JP21.2, JP21.3, JP21.4, JP21.5
unnamed: JP22.1, JP22.2, JP22.3, JP22.4, JP22.5
unnamed: JP23.1, JP23.2, JP23.3, JP23.4, JP23.5
unnamed: JP24.1, JP24.2, JP24.3, JP24.4, JP24.5
unnamed: JP25.1, JP25.2, JP25.3, JP25.4, JP25.5
unnamed: JP26.1, JP26.2, JP26.3, JP26.4, JP26.5
unnamed: JP27.1, JP27.2, JP27.3, JP27.4, JP27.5
unnamed: JP28.1, JP28.2, JP28.3, JP28.4, JP28.5
unnamed: JP29.1, JP29.2, JP29.3, JP29.4, JP29.5
unnamed: JP30.1, JP30.2, JP30.3, JP30.4, JP30.5
unnamed: JP31.1, JP31.2, JP31.3, JP31.4, JP31.5
unnamed: JP32.1, JP32.2, JP32.3, JP32.4, JP32.5
unnamed: JP33.1, JP33.2, JP33.3, JP33.4, JP33.5
unnamed: JP34.1, JP34.2, JP34.3, JP34.4, JP34.5
unnamed: JP35.1, JP35.2, JP35.3, JP35.4, JP35.5
unnamed: JP36.1, JP36.2, JP36.3, JP36.4, JP36.5
unnamed: JP37.1, JP37.2, JP37.3, JP37.4, JP37.5
unnamed: JP38.1, JP38.2, JP38.3, JP38.4, JP38.5
unnamed: JP39.1, JP39.2, JP39.3, JP39.4, JP39.5
unnamed: JP40.1, JP40.2, JP40.3, JP40.4, JP40.5
unnamed: JP41.1, JP41.2, JP41.3, JP41.4, JP41.5
unnamed: JP42.1, JP42.2, JP42.3, JP42.4, JP42.5
unnamed: JP43.1, JP43.2, JP43.3, JP43.4, JP43.5
unnamed: JP44.1, JP44.2, JP44.3, JP44.4, JP44.5
unnamed: JP45.1, JP45.2, JP45.3, JP45.4, JP45.5
unnamed: JP46.1, JP46.2, JP46.3, JP46.4, JP46.5
unnamed: JP47.1, JP47.2, JP47.3, JP47.4, JP47.5
unnamed: JP48.1, JP48.2, JP48.3, JP48.4, JP48.5
unnamed: JP49.1, JP49.2, JP49.3, JP49.4, JP49.5
unnamed: JP50.1, JP50.2, JP50.3, JP50.4, JP50.5
unnamed: JP51.1, JP51.2, JP51.3, JP51.4, JP51.5
unnamed: JP52.1, JP52.2, JP52.3, JP52.4, JP52.5
unnamed: JP53.1, JP53.2, JP53.3, JP53.4, JP53.5
unnamed: JP54.1, JP54.2, JP54.3, JP54.4, JP54.5
unnamed: JP55.1, JP55.2, JP55.3, JP55.4, JP55.5
unnamed: JP56.1, JP56.2, JP56.3, JP56.4, JP56.5
unnamed: JP57.1, JP57.2, JP57.3, JP57.4, JP57.5
unnamed: JP58.1, JP58.2, JP58.3, JP58.4, JP58.5
unnamed: JP59.1, JP59.2, JP59.3, JP59.4, JP59.5
unnamed: JP60.1, JP60.2, JP60.3, JP60.4, JP60.5
unnamed: JP61.1, JP61.2, JP61.3, JP61.4, JP61.5
unnamed: JP62.1, JP62.2, JP62.3, JP62.4, JP62.5
unnamed: JP63.1, JP63.2, JP63.3, JP63.4, JP63.5
unnamed: JP64.1, JP64.2, JP64.3, JP64.4, JP64.5
unnamed: JP65.1, S2.P1
unnamed: JP66.1, S1.P1
unnamed: JP67.1, S3.P1
unnamed: JP68.1, S4.P1

Notes on the sheet:
Byron Jacquot
V10

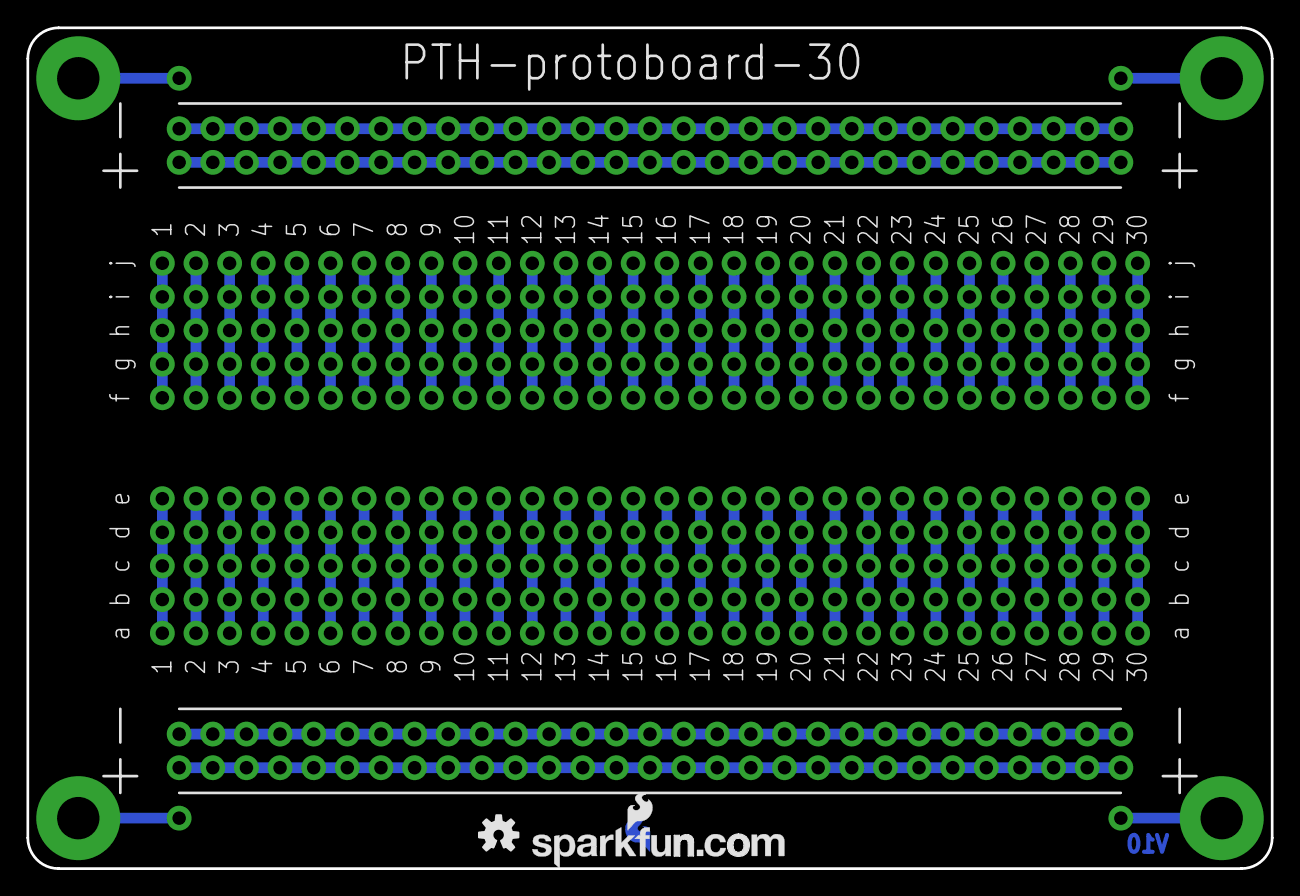
[picture p35: board SIK-DIP-board.brd from above]

Board: 2 copper layers, 94.0 x 63.5 mm, 76 parts (1 on the bottom side), 68 nets.
