LearningByMaking/Hardware/AppBoard1.2/App_Board_V1.2.brd

## EAGLE design AppBoard1.2/App_Board_V1.2.brd (2015-01-09)

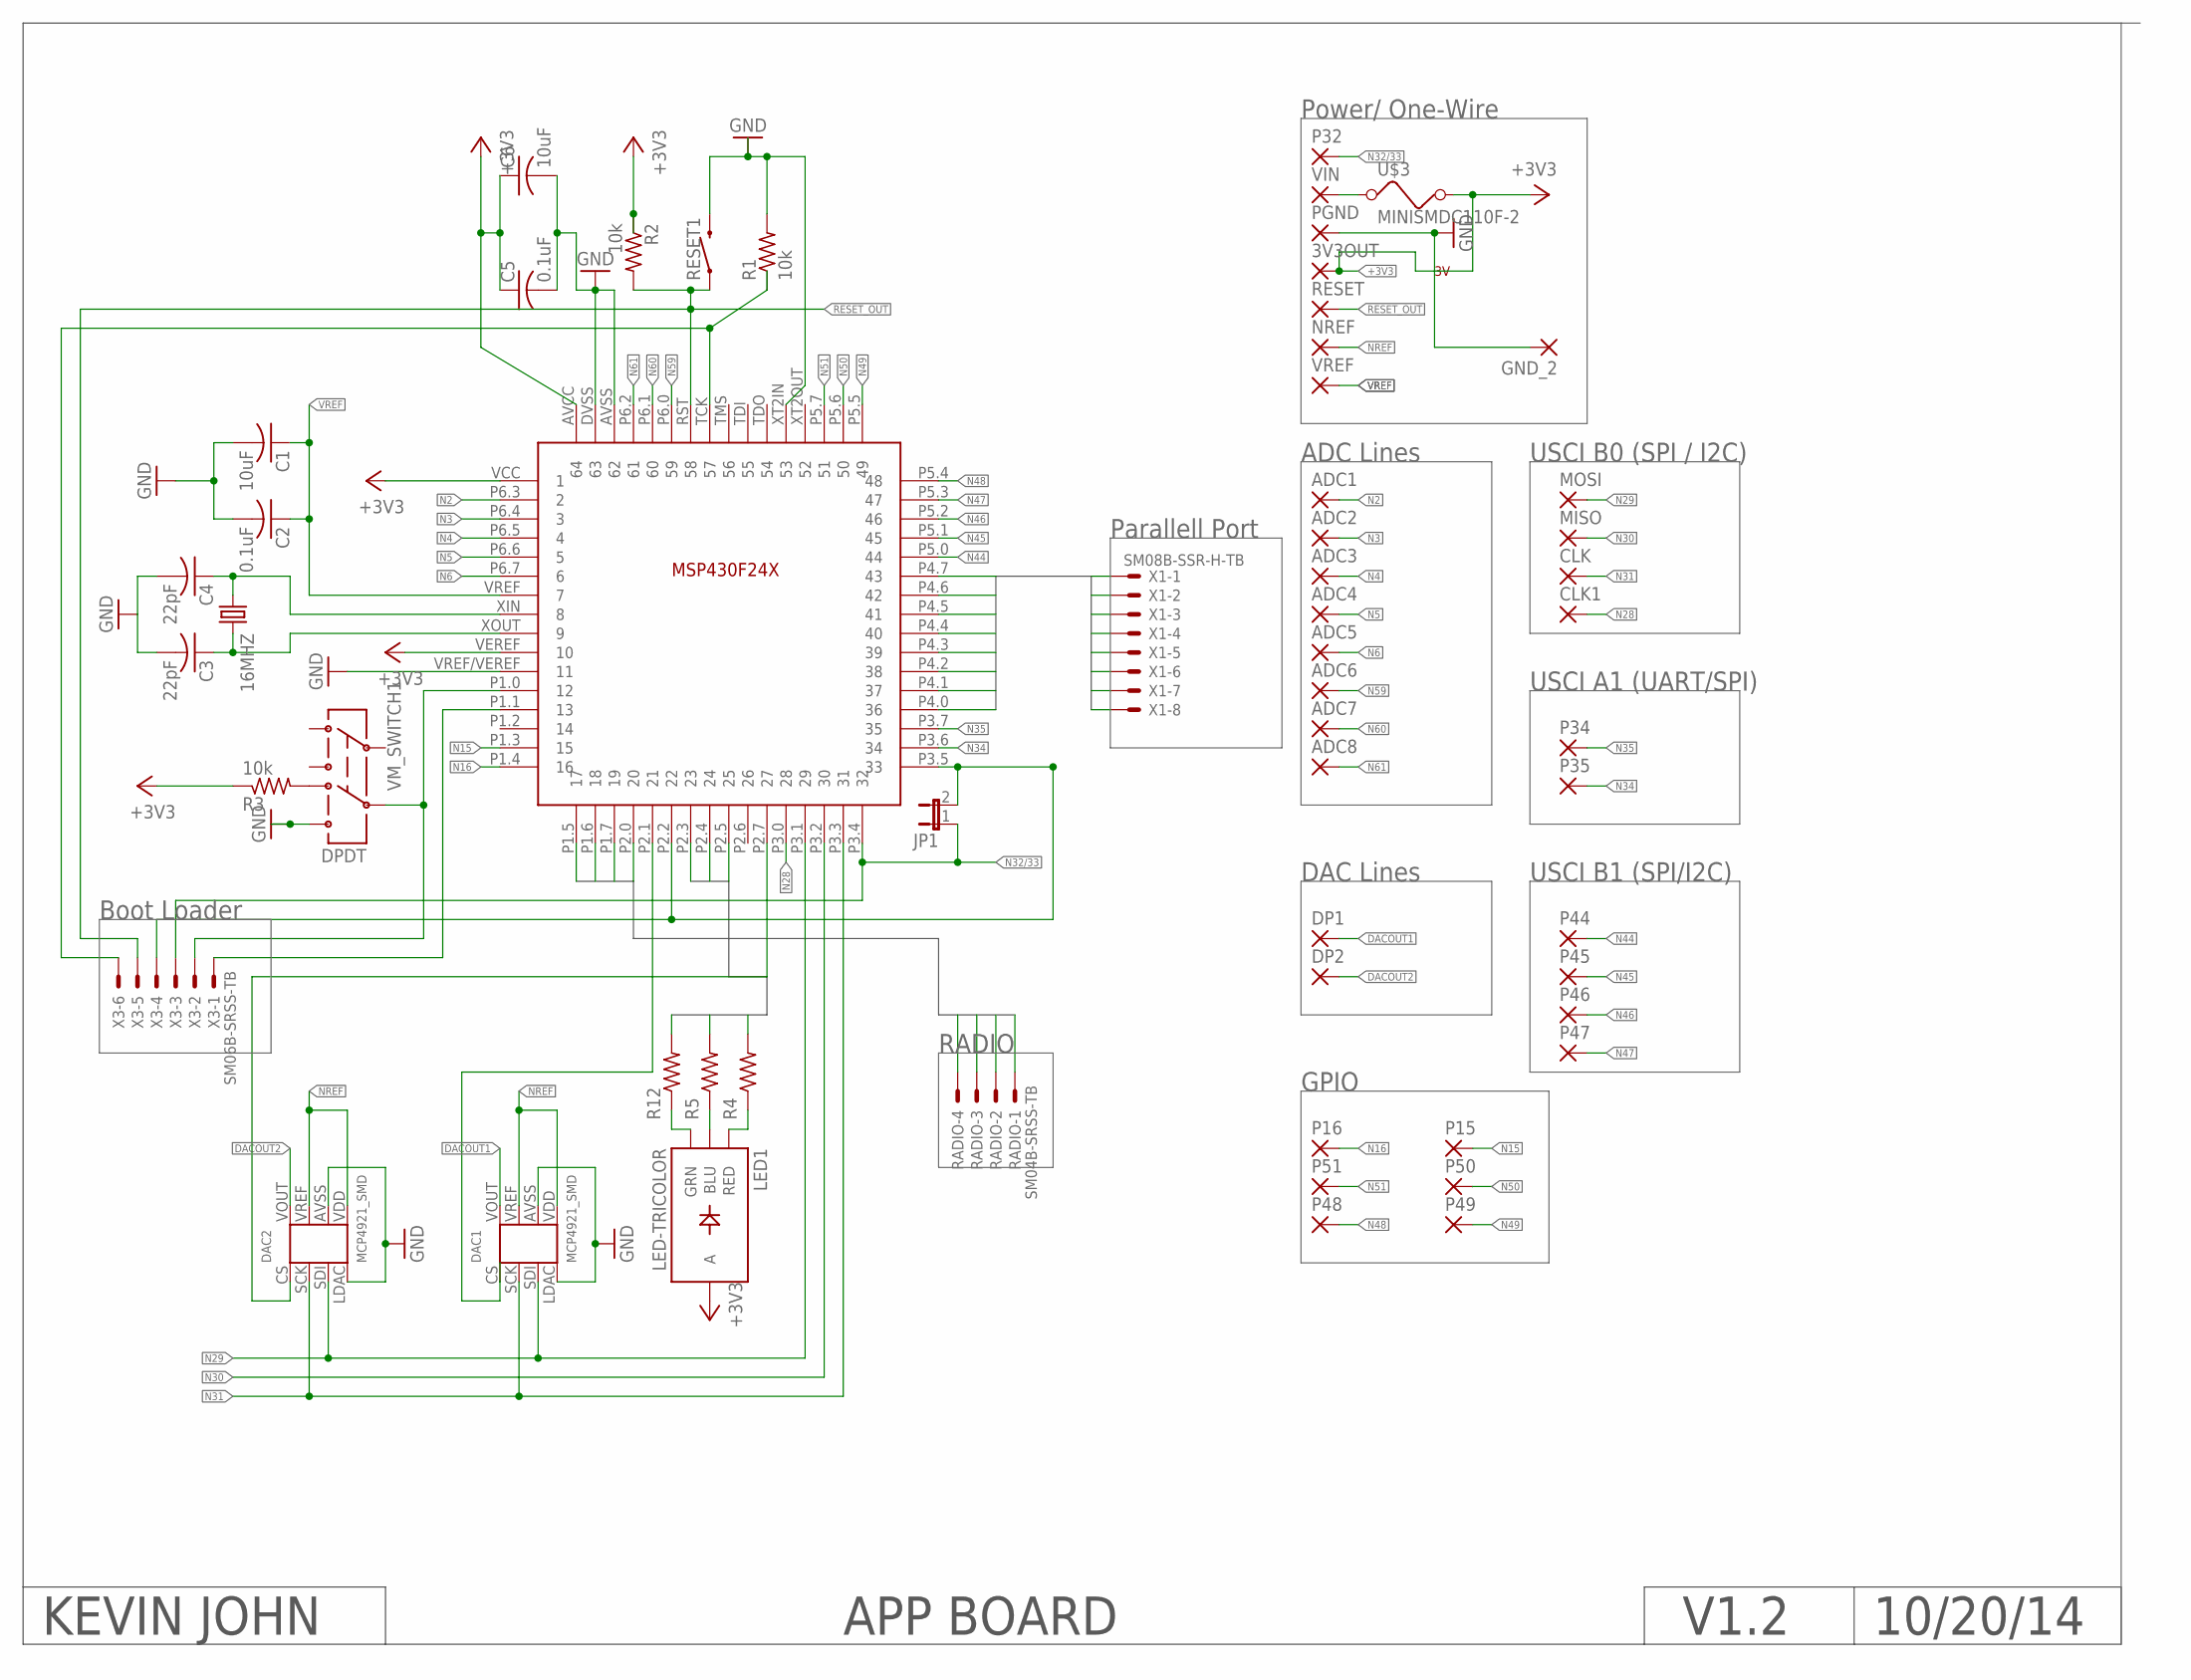
[picture p36: schematic App_Board_V1.2.sch]

Parts:
3V3OUT: 1,6/0,9
16MHZ: CRYSTAL5X3; CRYSTAL-SMD-5X3
ADC1, ADC2, ADC3, ADC4, ADC5, ADC6, ADC7, ADC8: 1,6/0,9
C1: 10uF; C0805
C2, C5: 0.1uF; C0805
C3, C4: 22pF; C0805
C6: 10uF; C1210
CLK, CLK1: 1,6/0,9
DAC1, DAC2: MCP4921_SMD
DP1, DP2: 1,6/0,9
GND_2: 1,6/0,9
JP1: JP1E; JP1
LED1: LED-TRICOLOR; LED-TRICOLOR-SMD
MISO: 1,6/0,9
MOSI: 1,6/0,9
NREF: 1,6/0,9
P15, P16, P32, P34, P35, P44, P45, P46, P47, P48, P49, P50, P51: 1,6/0,9
PGND: 1,6/0,9
R1, R2, R3: 10k; R0603
R4, R5, R12: 100; R0603
RADIO: SM04B-SRSS-TB
RESET: 1,6/0,9
RESET1: SWITCH-MOMENTARY-2SMD; TACTILE_SWITCH_SMD
U$1: MSP430
U$3: MINISMDC110F-2; MINISMDC110
VIN: 1,6/0,9
VM_SWITCH1: DPDT; AYZ0202
VREF: 1,6/0,9
X1: SM08B-SSR-H-TB
X3: SM06B-SRSS-TB

Connections:
3.3VOUT: U$3.P$1 (1), VIN.1
+3V3: 3V3OUT.1, C5.1, C6.1, LED1.A, R2.1, R3.1, U$1.AVCC (64), U$1.VCC (1), U$1.VEREF (10), U$3.P$2 (2)
DACOUT1: DAC1.VOUT, DP1.1
DACOUT2: DAC2.VOUT, DP2.1
GND: C1.2, C2.2, C3.2, C4.2, C5.2, C6.2, DAC1.AVSS (VCC), DAC1.LDAC (LADC), DAC2.AVSS (VCC), DAC2.LDAC (LADC), GND_2.1, PGND.1, R1.2, RESET1.3 (2), U$1.AVSS (62), U$1.DVSS (63), U$1.VREF/VEREF (11), U$1.XT2IN (53), VM_SWITCH1.6
LED0: R5.2, U$1.P2.3 (23)
LED1: R12.2, U$1.P2.4 (24)
LED2: R4.2, U$1.P2.5 (25)
N2: ADC1.1, U$1.P6.3 (2)
N3: ADC2.1, U$1.P6.4 (3)
N4: ADC3.1, U$1.P6.5 (4)
N5: ADC4.1, U$1.P6.6 (5)
N6: ADC5.1, U$1.P6.7 (6)
N15: P15.1, U$1.P1.3 (15)
N16: P16.1, U$1.P1.4 (16)
N20: DAC2.CS, U$1.P2.7 (27)
N28: CLK1.1, U$1.P3.0 (28)
N29: DAC1.SDI, DAC2.SDI, MOSI.1, U$1.P3.1 (29)
N30: MISO.1, U$1.P3.2 (30)
N31: CLK.1, DAC1.SCK, DAC2.SCK, U$1.P3.3 (31)
N32: JP1.2, U$1.P2.2 (22), U$1.P3.5 (33), X3.4
N32/33: JP1.1, P32.1, U$1.P3.4 (32), X3.3
N34: P35.1, U$1.P3.6 (34)
N35: P34.1, U$1.P3.7 (35)
N44: P44.1, U$1.P5.0 (44)
N45: P45.1, U$1.P5.1 (45)
N46: P46.1, U$1.P5.2 (46)
N47: P47.1, U$1.P5.3 (47)
N48: P48.1, U$1.P5.4 (48)
N49: P49.1, U$1.P5.5 (49)
N50: P50.1, U$1.P5.6 (50)
N51: P51.1, U$1.P5.7 (51)
N59: ADC6.1, U$1.P6.0 (59)
N60: ADC7.1, U$1.P6.1 (60)
N61: ADC8.1, U$1.P6.2 (61)
unnamed: 16MHZ.1, C4.1, U$1.XIN (8)
unnamed: R3.2, VM_SWITCH1.4
unnamed: LED1.G (GRN), R12.1
unnamed: LED1.B (BLU), R5.1
unnamed: LED1.R (RED), R4.1
unnamed: U$1.P1.0 (12), VM_SWITCH1.5, X3.2
unnamed: DAC1.CS, U$1.P2.1 (21)
unnamed: 16MHZ.3 (2), C3.1, U$1.XOUT (9)
unnamed: U$1.P1.1 (13), X3.1
NREF: DAC1.VDD, DAC1.VREF, DAC2.VDD, DAC2.VREF, NREF.1
RADIO_IRQ: RADIO.3, U$1.P1.6 (18)
RADIO_RX: RADIO.2, U$1.P1.7 (19)
RADIO_SELECT: RADIO.4, U$1.P1.5 (17)
RADIO_TX: RADIO.1, U$1.P2.0 (20)
RESET_OUT: R2.2, RESET.1, RESET1.1, U$1.RST (58), X3.5
RTS1: R1.1, U$1.TCK (57), X3.6
SERIAL0: U$1.P4.7 (43), X1.1
SERIAL1: U$1.P4.6 (42), X1.2
SERIAL2: U$1.P4.5 (41), X1.3
SERIAL3: U$1.P4.4 (40), X1.4
SERIAL4: U$1.P4.3 (39), X1.5
SERIAL5: U$1.P4.2 (38), X1.6
SERIAL6: U$1.P4.1 (37), X1.7
SERIAL7: U$1.P4.0 (36), X1.8
VREF: C1.1, C2.1, U$1.VREF (7), VREF.1

Notes on the sheet:
KEVIN JOHN
APP BOARD
V1.2
10/20/14
Power/ One-Wire
ADC Lines
DAC Lines
Parallell Port
USCI B0 (SPI / I2C)
Boot Loader
USCI A1 (UART/SPI)
USCI B1 (SPI/I2C)
GPIO
RADIO

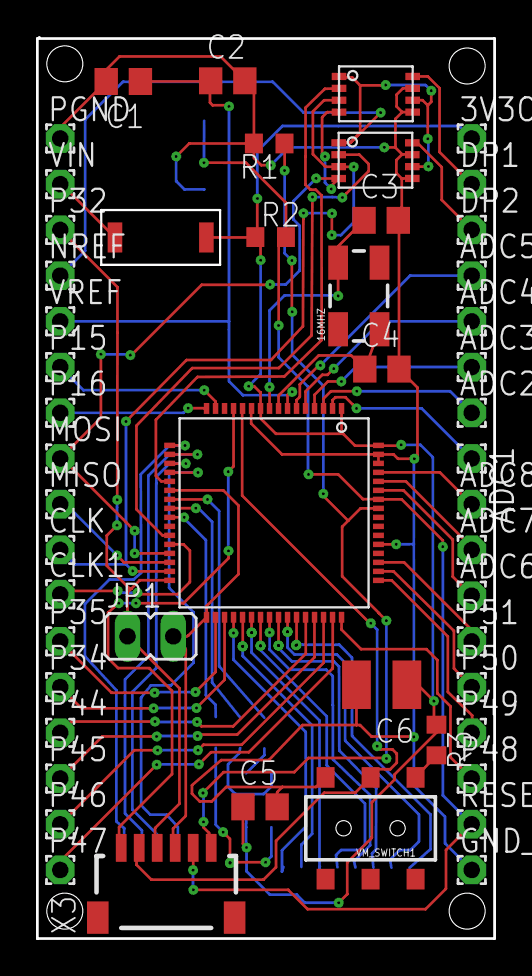
[picture p37: board App_Board_V1.2.brd from above]

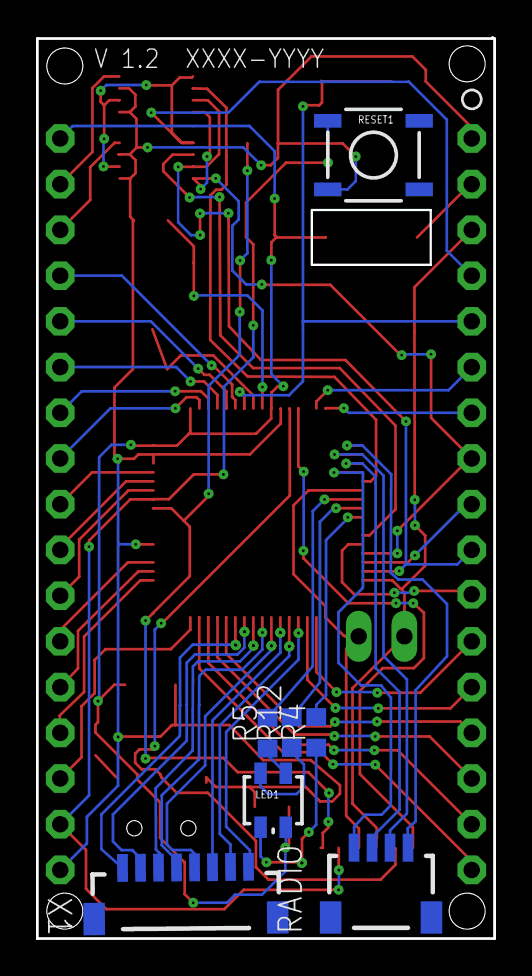
[picture p38: board App_Board_V1.2.brd from below]

Board: 2 copper layers, 25.4 x 50.0 mm, 58 parts (7 on the bottom side), 60 nets.
