LearningByMaking/Hardware/AppBoard1.3/App_Board_V1.31_bottom_labeled.brd

## EAGLE design AppBoard1.3/App_Board_V1.31_bottom_labeled.brd (2016-04-11)

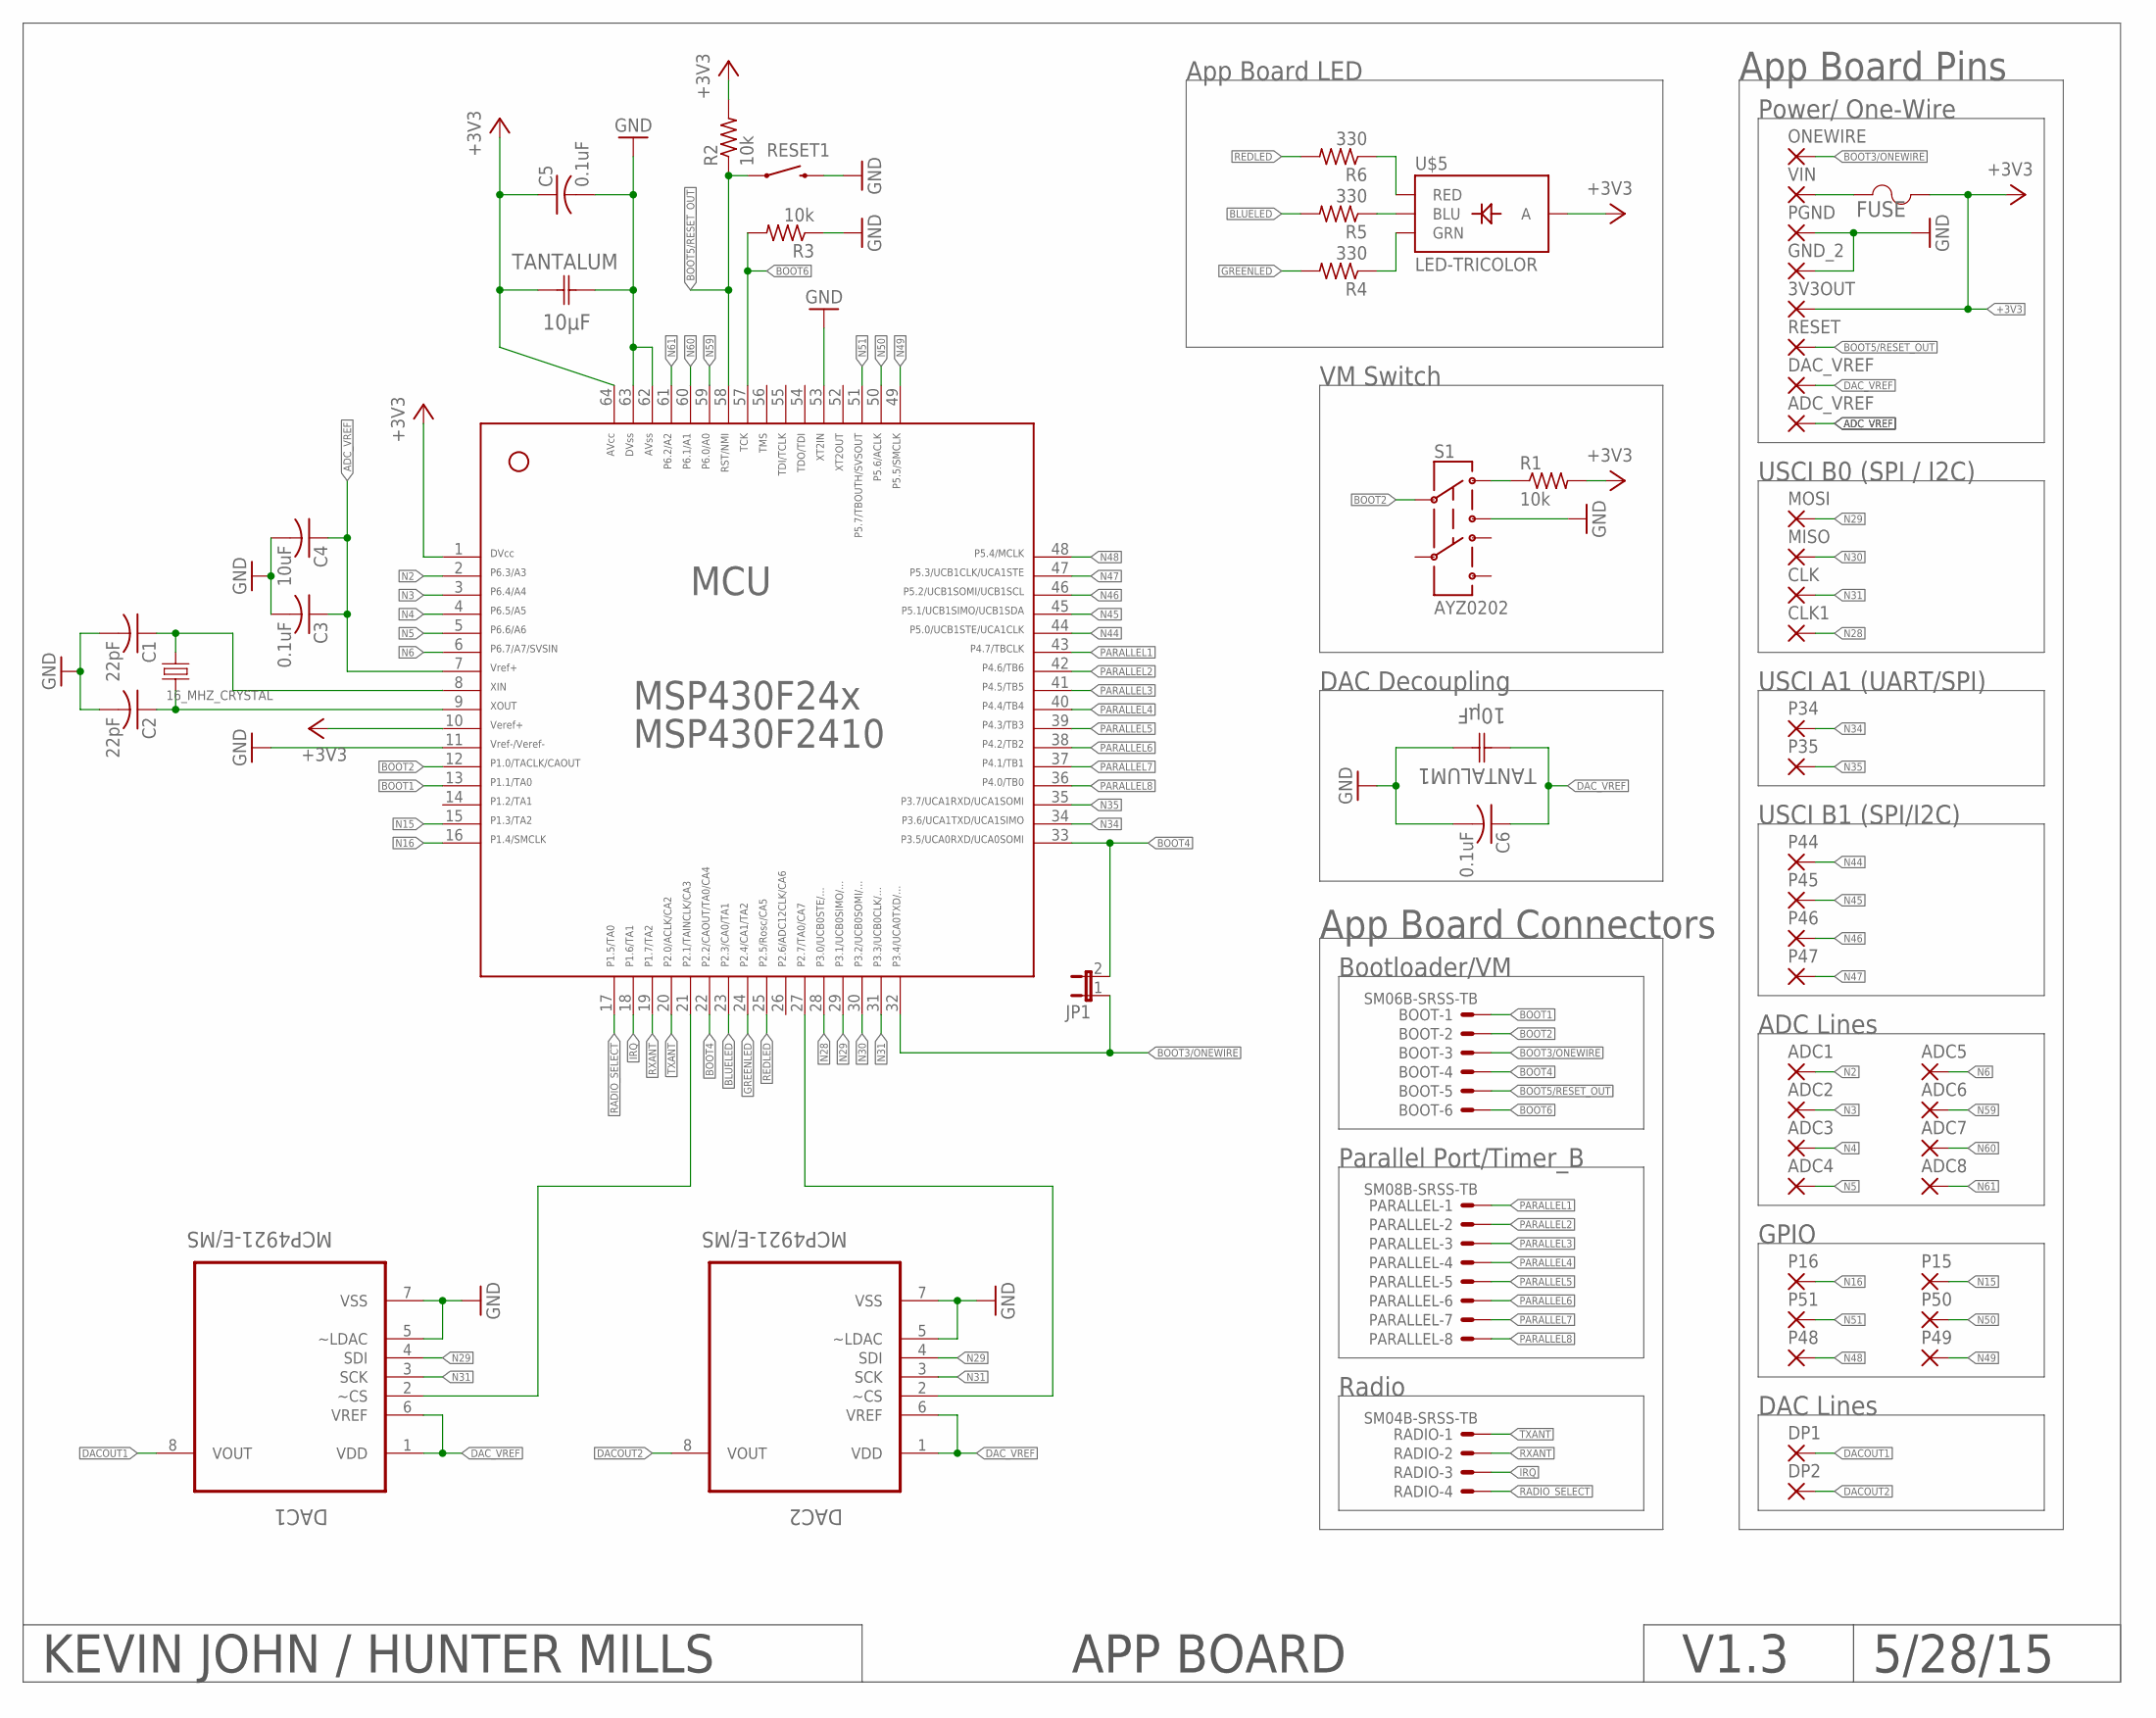
[picture p39: schematic App_Board_V1.31_bottom_labeled.sch]

Parts:
3V3OUT: 1,6/0,9
16_MHZ_CRYSTAL: HUNTERCRYSTAL; CRYSTAL-SMD-5X3
ADC1, ADC2, ADC3, ADC4, ADC5, ADC6, ADC7, ADC8: 1,6/0,9
ADC_VREF: 1,6/0,9
BOOT: SM06B-SRSS-TB
C1, C2: 22pF; C0805
C3, C5, C6: 0.1uF; C0805
C4: 10uF; C0805
CLK, CLK1: 1,6/0,9
DAC1, DAC2: MCP4921-E/MS; SOP65P490X110-8N
DAC_VREF: 1,6/0,9
DP1, DP2: 1,6/0,9
FUSE: HUNTERFUSE; CAPC4532X254N
GND_2: 1,6/0,9
JP1: JP1E; JP1
MCU: F24[X/10]---PM64; PM/PAG64
MISO: 1,6/0,9
MOSI: 1,6/0,9
ONEWIRE: 1,6/0,9
P15, P16, P34, P35, P44, P45, P46, P47, P48, P49, P50, P51: 1,6/0,9
PARALLEL: SM08B-SRSS-TB
PGND: 1,6/0,9
R1, R2, R3: 10k; R0603
R4, R5, R6: 330; R0603
RADIO: SM04B-SRSS-TB
RESET: 1,6/0,9
RESET1: SWITCH-MOMENTARY-2SMD; TACTILE-SWITCH-SMD
S1: AYZ0202
TANTALUM, TANTALUM1: 10µF; CAPCP3528X120N
U$5: LED-TRICOLOR; LED-TRICOLOR-SMD
VIN: 1,6/0,9

Connections:
3.3VOUT: FUSE.1, VIN.1
+3V3: 3V3OUT.1, C5.1, FUSE.2, MCU.1, MCU.10, MCU.64, R1.2, R2.2, TANTALUM.1 (C1), U$5.A
ADC_VREF: ADC_VREF.1, C3.1, C4.1, MCU.7
BLUELED: MCU.23, R5.2
BOOT1: BOOT.1, MCU.13
BOOT2: BOOT.2, MCU.12, S1.2
BOOT3/ONEWIRE: BOOT.3, JP1.1, MCU.32, ONEWIRE.1
BOOT4: BOOT.4, JP1.2, MCU.22, MCU.33
BOOT5/RESET_OUT: BOOT.5, MCU.58, R2.1, RESET.1, RESET1.1
BOOT6: BOOT.6, MCU.57, R3.2
DACOUT1: DAC1.8 (VOUT), DP1.1
DACOUT2: DAC2.8 (VOUT), DP2.1
DAC_VREF: C6.1, DAC1.1 (VDD), DAC1.6 (VREF), DAC2.1 (VDD), DAC2.6 (VREF), DAC_VREF.1, TANTALUM1.1 (C1)
GND: C1.2, C2.2, C3.2, C4.2, C5.2, C6.2, DAC1.5 (~LDAC), DAC1.7 (VSS), DAC2.5 (~LDAC), DAC2.7 (VSS), GND_2.1, MCU.11, MCU.53, MCU.62, MCU.63, PGND.1, R3.1, RESET1.3 (2), S1.1 (3), TANTALUM.2 (C2), TANTALUM1.2 (C2)
GREENLED: MCU.24, R4.2
IRQ: MCU.18, RADIO.3
N2: ADC1.1, MCU.2
N3: ADC2.1, MCU.3
N4: ADC3.1, MCU.4
N5: ADC4.1, MCU.5
N6: ADC5.1, MCU.6
N15: MCU.15, P15.1
N16: MCU.16, P16.1
N28: CLK1.1, MCU.28
N29: DAC1.4 (SDI), DAC2.4 (SDI), MCU.29, MOSI.1
N30: MCU.30, MISO.1
N31: CLK.1, DAC1.3 (SCK), DAC2.3 (SCK), MCU.31
N34: MCU.34, P34.1
N35: MCU.35, P35.1
N44: MCU.44, P44.1
N45: MCU.45, P45.1
N46: MCU.46, P46.1
N47: MCU.47, P47.1
N48: MCU.48, P48.1
N49: MCU.49, P49.1
N50: MCU.50, P50.1
N51: MCU.51, P51.1
N59: ADC6.1, MCU.59
N60: ADC7.1, MCU.60
N61: ADC8.1, MCU.61
unnamed: 16_MHZ_CRYSTAL.3, C1.1, MCU.8
unnamed: 16_MHZ_CRYSTAL.1, C2.1, MCU.9
unnamed: R1.1, S1.3 (1)
unnamed: R5.1, U$5.B (BLU)
unnamed: R6.1, U$5.R (RED)
unnamed: R4.1, U$5.G (GRN)
unnamed: DAC1.2 (~CS), MCU.21
unnamed: DAC2.2 (~CS), MCU.27
PARALLEL1: MCU.43, PARALLEL.1
PARALLEL2: MCU.42, PARALLEL.2
PARALLEL3: MCU.41, PARALLEL.3
PARALLEL4: MCU.40, PARALLEL.4
PARALLEL5: MCU.39, PARALLEL.5
PARALLEL6: MCU.38, PARALLEL.6
PARALLEL7: MCU.37, PARALLEL.7
PARALLEL8: MCU.36, PARALLEL.8
RADIO_SELECT: MCU.17, RADIO.4
REDLED: MCU.25, R6.2
RXANT: MCU.19, RADIO.2
TXANT: MCU.20, RADIO.1

Notes on the sheet:
KEVIN JOHN / HUNTER MILLS
APP BOARD
V1.3
5/28/15
Power/ One-Wire
ADC Lines
DAC Lines
USCI B0 (SPI / I2C)
USCI A1 (UART/SPI)
USCI B1 (SPI/I2C)
GPIO
App Board Pins
Bootloader/VM
Parallel Port/Timer_B
Radio
App Board Connectors
App Board LED
VM Switch
DAC Decoupling

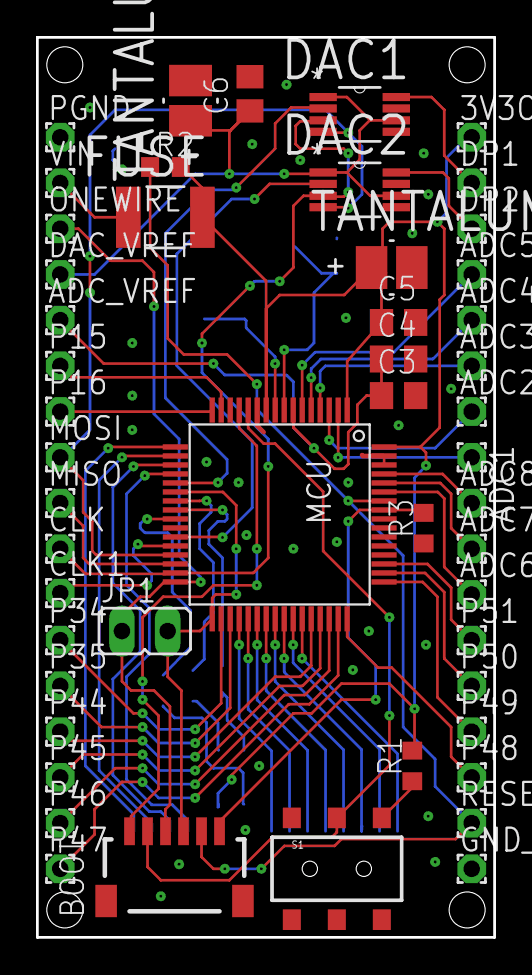
[picture p40: board App_Board_V1.31_bottom_labeled.brd from above]

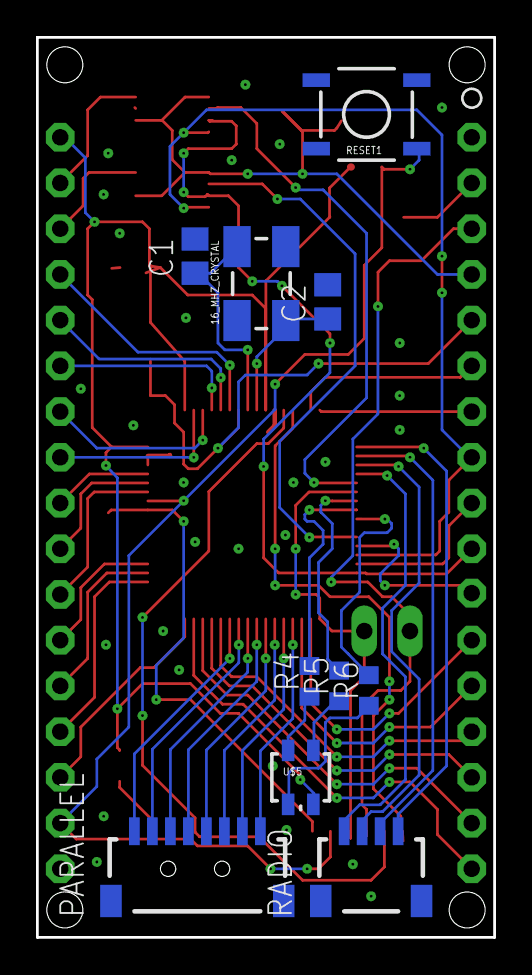
[picture p41: board App_Board_V1.31_bottom_labeled.brd from below]

Board: 2 copper layers, 25.4 x 50.0 mm, 60 parts (10 on the bottom side), 60 nets.
