LearningByMaking/Hardware/DevBoard/Dev_Board_V3.5.brd

## EAGLE design DevBoard/Dev_Board_V3.5.brd (2015-01-09)

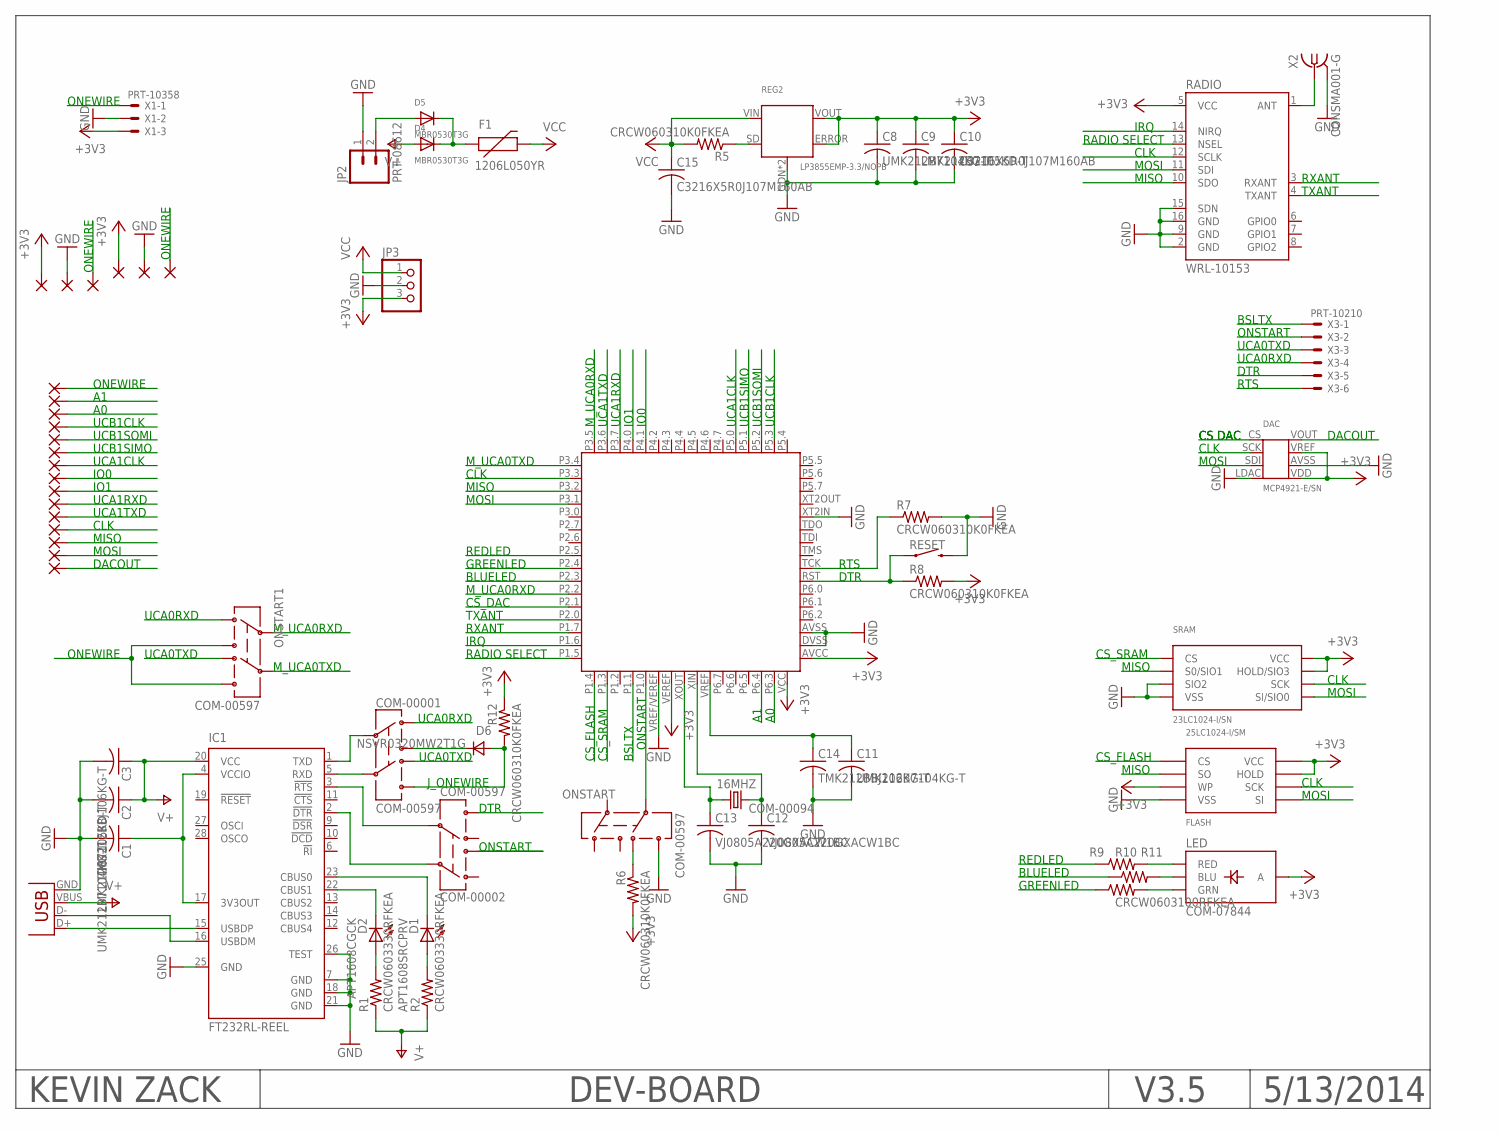
[picture p42: schematic Dev_Board_V3.5.sch]

Parts:
16MHZ: COM-00094; CRYSTAL-SMD-5X3
+3.1, +3.3: 1,6/0,9
A0, A1, A2, A3, A4: 1,6/0,9
C1, C8, C11: UMK212B7104KG-T; C0805
C2, C9: LMK212B7105KD-T; C0805
C3, C14: TMK212BBJ106KG-T; C0805
C10, C15: C3216X5R0J107M160AB; C1206
C12, C13: VJ0805A220GXACW1BC; C0805
CLK: 1,6/0,9
COM-00001, COM-00002: COM-00597; AYZ0202
D1: APT1608SRCPRV; LED-0603
D2: APT1608CGCK; LED-0603
D4, D5: MBR0530T3G; SOD-123
D6: NSVR0320MW2T1G; SOD323; MPN CDSOD323-T05C
DAC: MCP4921-E/SN; MCP4921_SMD
DACOUT: 1,6/0,9
F1: 1206L050YR; PTC-1206
FLASH: 25LC1024-I/SM; 25LC1024
GND, GND26: 1,6/0,9
IC1: FT232RL-REEL; SSOP28
IO0, IO1: 1,6/0,9
JP1: 1734035-2; USB-MINIB-NOSTOP
JP2: PRT-08612; JST-2-SMD
JP3: PINHD-1X3; 1X03
LED: COM-07844; LED-TRICOLOR-SMD
MISO: 1,6/0,9
MOSI: 1,6/0,9
ONSTART, ONSTART1: COM-00597; AYZ0202
R1, R2: CRCW0603330RFKEA; R0603
R5, R6, R7, R8, R12: CRCW060310K0FKEA; R0603
R9, R10, R11: CRCW0603100RFKEA; R0603
RADIO: WRL-10153; RFM22-XXX-S2
REG2: LP3855EMP-3.3/NOPB; LP3855EMP
RESET: COM-08720; TACTILE_SWITCH_SMD
SRAM: 23LC1024-I/SN; 23LC1024
U$3: MSP430F2410TPMR; MSP430F248
UCA1CLK, UCA1RXD, UCA1TXD: 1,6/0,9
UCB1CLK, UCB1SIMO, UCB1SOMI: 1,6/0,9
X1: PRT-10358; BM03B-SRSS-TB
X2: CONSMA001-G; BU-SMA-V
X3: PRT-10210; SM06B-SRSS-TB

Connections:
+3V3: +3.1.1, +3.3.1, C8.1, C9.1, C10.1, DAC.VDD, DAC.VREF, FLASH.HOLD, FLASH.VCC, FLASH.WP, JP3.3, LED.A, R6.2, R8.2, R12.1, RADIO.5 (VCC), REG2.ERROR, REG2.VOUT, SRAM.HOLD/SIO3, SRAM.VCC, U$3.AVCC, U$3.VCC (DVCC), U$3.VEREF, X1.3
A0: A0.1, U$3.P6.3
A1: A1.1, U$3.P6.4
BLUELED: R10.1, U$3.P2.3
BSLTX: U$3.P1.1, X3.1
CLK: CLK.1, DAC.SCK, FLASH.SCK, RADIO.12 (SCLK), SRAM.SCK, U$3.P3.3
CSRADIO: RADIO.13 (NSEL), U$3.P1.5
CS_DAC: DAC.CS, U$3.P2.1
CS_FLASH: FLASH.CS, U$3.P1.4
CS_SRAM: SRAM.CS, U$3.P1.3
DACOUT: DAC.VOUT, DACOUT.1
DTR: COM-00002.6, R8.1, RESET.1, U$3.RST, X3.5
GND: C1.2, C2.2, C3.2, C8.2, C9.2, C10.2, C11.2, C12.2, C13.2, C14.2, C15.2, DAC.AVSS (VCC), DAC.LDAC (LADC), FLASH.VSS, GND.1, GND26.1, IC1.7 (GND), IC1.18 (GND), IC1.21 (GND), IC1.25 (GND), IC1.26 (TEST), JP1.GND, JP2.1 (2), JP3.2, ONSTART.6, R7.2, RADIO.2 (GND), RADIO.9 (GND), RADIO.15 (SDN), RADIO.16 (GND), REG2.GDN (GND), REG2.GND, RESET.3 (2), SRAM.SIO2, SRAM.VSS, U$3.AVSS, U$3.DVSS, U$3.VREF/VEREF, U$3.XT2IN, X1.2, X2.2 (GND), X2.3 (GND), X2.4 (GND), X2.5 (GND)
GREENLED: R11.1, U$3.P2.4
IO0: IO0.1, U$3.P4.1
IO1: IO1.1, U$3.P4.0
IRQ: RADIO.14 (NIRQ), U$3.P1.6
MISO: FLASH.SO, MISO.1, RADIO.10 (SDO), SRAM.SO/SIO1 (S0/SIO1), U$3.P3.2
MOSI: DAC.SDI, FLASH.SI, MOSI.1, RADIO.11 (SDI), SRAM.SI/SIO0, U$3.P3.1
M_UCA0RXD: ONSTART1.2, U$3.P2.2, U$3.P3.5
M_UCA0TXD: ONSTART1.5, U$3.P3.4
unnamed: D1.C, IC1.23 (CBUS0)
unnamed: IC1.16 (USBDM), JP1.D-
unnamed: IC1.15 (USBDP), JP1.D+
unnamed: C1.1, IC1.4 (VCCIO), IC1.17 (3V3OUT)
unnamed: D2.C, IC1.22 (CBUS1)
unnamed: D2.A, R1.2
unnamed: D1.A, R2.2
unnamed: R5.1, REG2.SD
unnamed: D5.A, JP2.2 (1)
unnamed: COM-00001.5, IC1.5 (RXD)
unnamed: ONSTART.4, R6.1
unnamed: LED.R (RED), R9.2
unnamed: RADIO.1 (ANT), X2.1
unnamed: LED.B (BLU), R10.2
unnamed: C11.1, C14.1, U$3.VREF
unnamed: LED.G (GRN), R11.2
unnamed: COM-00001.3, D6.1 (C)
unnamed: D4.C, D5.C, F1.1
unnamed: COM-00002.5, IC1.3 (!RTS)
unnamed: 16MHZ.1, C13.1, U$3.XOUT
unnamed: 16MHZ.3 (2), C12.1, U$3.XIN
unnamed: COM-00001.2, IC1.1 (TXD)
unnamed: COM-00001.6, D6.2 (A), R12.2
unnamed: COM-00002.2, IC1.2 (!DTR)
ONEWIRE: A2.1, A3.1, A4.1, ONSTART1.3, ONSTART1.6, X1.1
ONSTART: COM-00002.3, ONSTART.5, U$3.P1.0, X3.2
REDLED: R9.1, U$3.P2.5
RTS: R7.1, U$3.TCK, X3.6
RXANT: RADIO.3 (RXANT), U$3.P1.7
TXANT: RADIO.4 (TXANT), U$3.P2.0
UCA0RXD: COM-00001.1, ONSTART1.1, X3.4
UCA0TXD: COM-00001.4, ONSTART1.4, X3.3
UCA1CLK: U$3.P5.0, UCA1CLK.1
UCA1RXD: U$3.P3.7, UCA1RXD.1
UCA1TXD: U$3.P3.6, UCA1TXD.1
UCB1CLK: U$3.P5.3, UCB1CLK.1
UCB1SIMO: U$3.P5.1, UCB1SIMO.1
UCB1SOMI: U$3.P5.2, UCB1SOMI.1
V+: C2.1, C3.1, D4.A, IC1.20 (VCC), JP1.VBUS, R1.1, R2.1
VCC: C15.1, F1.2, JP3.1, R5.2, REG2.VIN

Notes on the sheet:
CS DAC
CLK
MOSI
DACOUT
MISO
ONSTART
BSLTX
CS_SRAM
CS_FLASH
RADIO SELECT
IRQ
RXANT
TXANT
REDLED
BLUELED
GREENLED
UCB1SOMI
UCB1SIMO
UCA1CLK
UCB1CLK
UCA1TXD
UCA1RXD
IO1
IO0
KEVIN ZACK
DEV-BOARD
V3.5
5/13/2014
UCA0RXD
UCA0TXD
DTR
RTS
ONEWIRE
M_UCA0RXD
M_UCA0TXD
J_ONEWIRE
CS_DAC

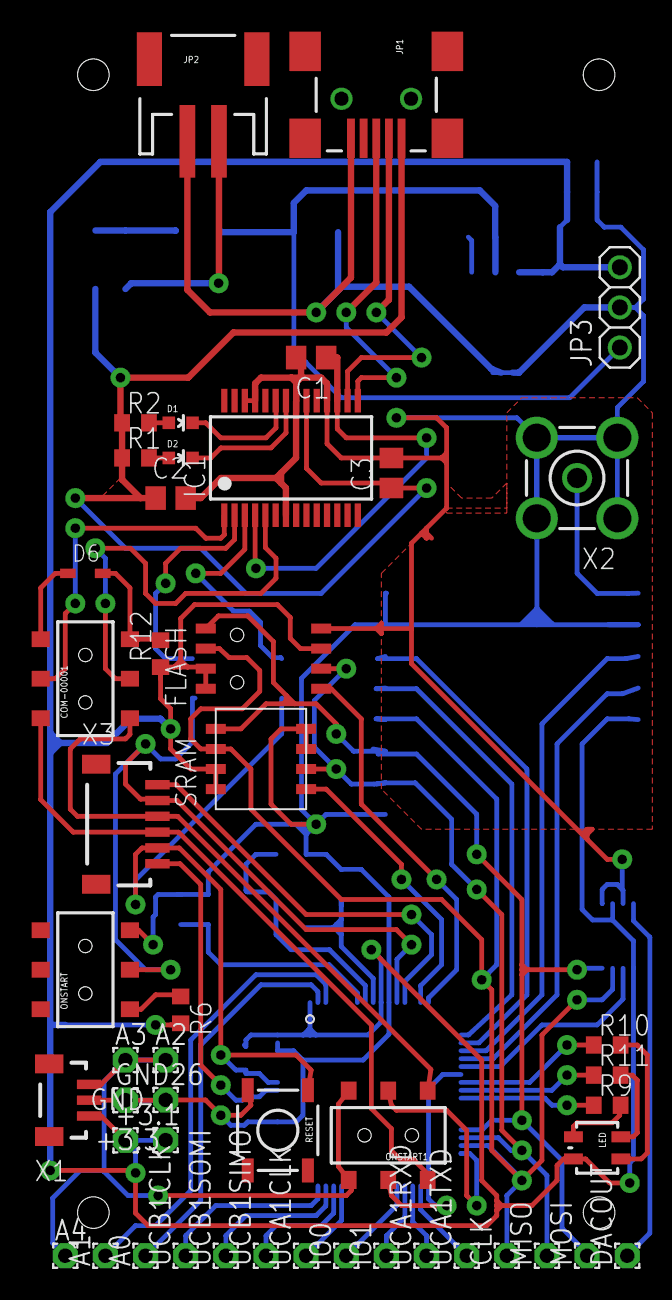
[picture p43: board Dev_Board_V3.5.brd from above]

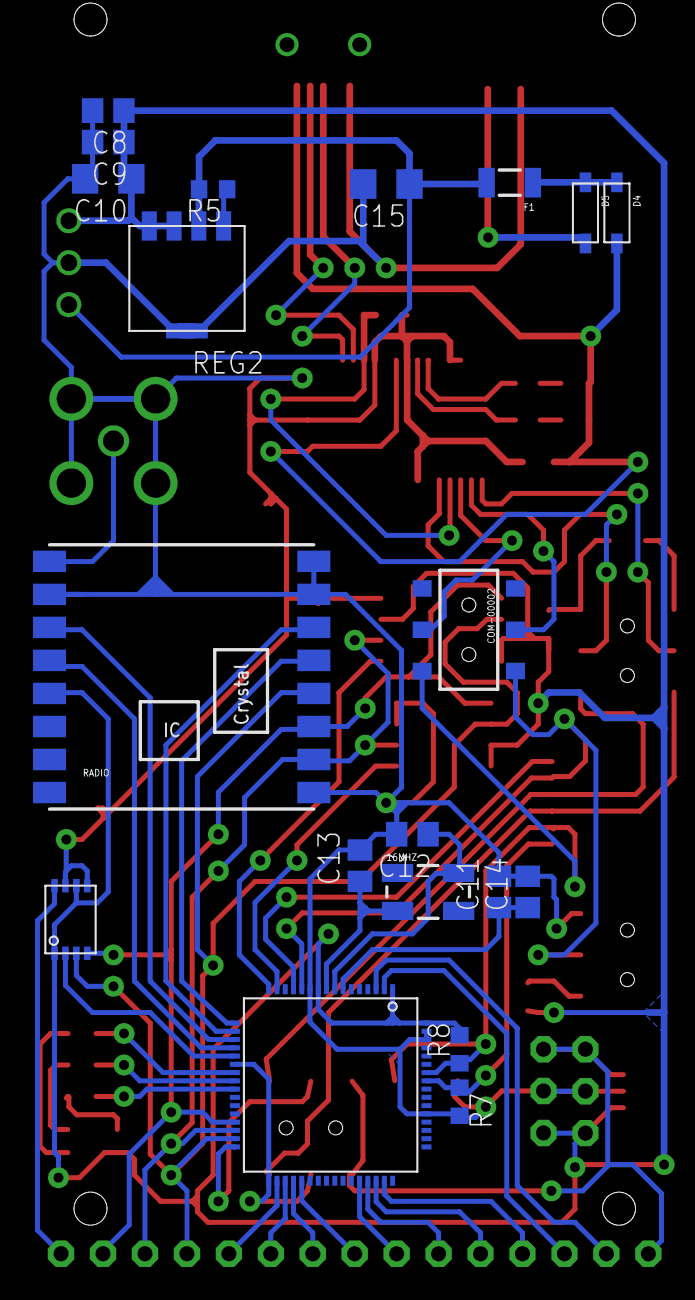
[picture p44: board Dev_Board_V3.5.brd from below]

Board: 2 copper layers, 68 parts (20 on the bottom side), 61 nets.
