LearningByMaking/Hardware/(commit log)

2015-01-09 Added all the existing files I have to initialize the repo
    [AppBoardParts.xlsx, App_Board_V1.2.brd, App_Board_V1.2.sch, App_Board_V1.2_Colored.sch, Bridge.sch, Dev_Board_V3.5.brd, Dev_Board_V3.5.sch, MSP430Layout.xlsx]
2015-02-04 Dimension adjustments of the "Appcore_Reveiver" package
    Adjustments to the dimensions of the package diagram "Appcore_Reveiver"
    were made to match the dimension of the "App_Board_V1.2" eagle diagram's
    pins and holes placements.
2015-02-13 Mirrored the App_Core library template
    The package template for the App Board v1.2 was flipped horizontally to
    match the foot print orientation it has when used to creating breakout
    boards.
2016-04-11 created new uStar layout
    [AppBoardParts.xlsx, App_Board_V1.2.brd, App_Board_V1.2.sch, App_Board_V1.2_Colored.sch, App_Board_V1.31.brd, App_Board_V1.31.sch, App_Board_V1.31_bottom_labeled.brd, App_Board_V1.31_bottom_labeled.sch]
2016-04-11 added changes submitted by Ben
    [uStar_v1.brd, uStar_v1.sch]
2016-04-20 added power management circuits and SD card
2016-04-20 added ADC lines instead of the uneeded ground
    [uStar_v1.brd, uStar_v1.sch]
2016-05-10 fixed clearance violations
    [uStar_v1.brd, uStar_v1.sch]
2016-05-13 refined and executed the DRC process, made appropriate changes
    [uStar_v1.brd]
2016-06-02 added order files and protoboard files
    [Board_4x8-Prototype_v20160405.brd, Board_4x8-Prototype_v20160405.sch, SIK-DIP-board.brd, SIK-DIP-board.sch, uStar_v1.brd]
2016-06-02 added gerber files for ustar and protoboard
    [Board_4x8-prototype_v160506.brd, Board_4x8-prototype_v160506.sch, PartList.xlsx, SIK-DIP-board.brd, SIK-DIP-board.sch, uStar_v1.brd, uStar_v1.sch]
2016-07-07 updates and stuff
    [FullPrototypingBoard.brd, FullPrototypingBoard.sch, PartList.xlsx, Protoboard.brd, Protoboard.sch, ProtoboardPartList.xlsx, uStar.brd, uStar.sch]
